iandchasse/silkscreen-light-strip/docs/reports/design_summary.md

# As-built design summary (generated by tools/report_design.py)

Coordinates: main-board KiCad frame (mm, front view, y down). The tail is drawn unrolled in +y past the
fold line y = 142.965 (panel bottom glass edge); x is preserved through the fold.

Board outline bbox: x 42.975..58.025, y 39.075..166.640
Board thickness 0.1040 mm; copper layers 2

## Footprints
| Ref | Value | Footprint | x | y | rot | pads (num: net @ x,y size) |
|---|---|---|---|---|---|---|
| D1 | XL-4008WWC | LED_SideView_XINGLIGHT_XL-4008 | 44.200 | 50.450 | -90 | 1: /W1_2 @ 44.250,52.300 1.60x1.00<br>2: /W_A @ 44.250,48.600 1.60x1.00 |
| D2 | XL-4008WWC | LED_SideView_XINGLIGHT_XL-4008 | 44.200 | 67.450 | -90 | 1: /W2_3 @ 44.250,69.300 1.60x1.00<br>2: /W1_2 @ 44.250,65.600 1.60x1.00 |
| D3 | XL-4008WWC | LED_SideView_XINGLIGHT_XL-4008 | 44.200 | 83.000 | -90 | 1: /W3_4 @ 44.250,84.850 1.60x1.00<br>2: /W2_3 @ 44.250,81.150 1.60x1.00 |
| D4 | XL-4008WWC | LED_SideView_XINGLIGHT_XL-4008 | 44.200 | 98.550 | -90 | 1: /W4_5 @ 44.250,100.400 1.60x1.00<br>2: /W3_4 @ 44.250,96.700 1.60x1.00 |
| D5 | XL-4008WWC | LED_SideView_XINGLIGHT_XL-4008 | 44.200 | 114.100 | -90 | 1: /W5_6 @ 44.250,115.950 1.60x1.00<br>2: /W4_5 @ 44.250,112.250 1.60x1.00 |
| D6 | XL-4008WWC | LED_SideView_XINGLIGHT_XL-4008 | 44.200 | 129.650 | -90 | 1: /W- @ 44.250,131.500 1.60x1.00<br>2: /W5_6 @ 44.250,127.800 1.60x1.00 |
| D7 | XL-4008UWC | LED_SideView_XINGLIGHT_XL-4008 | 44.200 | 43.850 | -90 | 1: /C7_8 @ 44.250,45.700 1.60x1.00<br>2: /C_A @ 44.250,42.000 1.60x1.00 |
| D8 | XL-4008UWC | LED_SideView_XINGLIGHT_XL-4008 | 44.200 | 60.850 | -90 | 1: /C8_9 @ 44.250,62.700 1.60x1.00<br>2: /C7_8 @ 44.250,59.000 1.60x1.00 |
| D9 | XL-4008UWC | LED_SideView_XINGLIGHT_XL-4008 | 44.200 | 76.400 | -90 | 1: /C9_10 @ 44.250,78.250 1.60x1.00<br>2: /C8_9 @ 44.250,74.550 1.60x1.00 |
| D10 | XL-4008UWC | LED_SideView_XINGLIGHT_XL-4008 | 44.200 | 91.950 | -90 | 1: /C10_11 @ 44.250,93.800 1.60x1.00<br>2: /C9_10 @ 44.250,90.100 1.60x1.00 |
| D11 | XL-4008UWC | LED_SideView_XINGLIGHT_XL-4008 | 44.200 | 107.500 | -90 | 1: /C11_12 @ 44.250,109.350 1.60x1.00<br>2: /C10_11 @ 44.250,105.650 1.60x1.00 |
| D12 | XL-4008UWC | LED_SideView_XINGLIGHT_XL-4008 | 44.200 | 123.050 | -90 | 1: /C- @ 44.250,124.900 1.60x1.00<br>2: /C11_12 @ 44.250,121.200 1.60x1.00 |
| D13 | BAV70W | SOT-323_SC-70 | 56.340 | 155.015 | 90 | 1: /LED_SW @ 55.690,156.015 0.45x0.70<br>2: /W- @ 56.990,156.015 0.45x0.70<br>3: /W_A @ 56.340,154.015 0.45x0.70 |
| D14 | BAV70W | SOT-323_SC-70 | 53.840 | 155.015 | 90 | 1: /LED_SW @ 53.190,156.015 0.45x0.70<br>2: /C- @ 54.490,156.015 0.45x0.70<br>3: /C_A @ 53.840,154.015 0.45x0.70 |
| J1 | FPC tail to J3 | FPC_Tail_FH34SRJ_6P_P0.50mm_TopContact | 54.237 | 166.615 | 0 | 1: /LED_SW @ 52.987,165.515 0.30x1.80<br>2: /C- @ 53.487,165.515 0.30x1.80<br>3: unconnected-(J1-NC-Pad3) @ 53.987,165.515 0.30x1.80<br>4: unconnected-(J1-NC-Pad4) @ 54.487,165.515 0.30x1.80<br>5: /LED_SW @ 54.987,165.515 0.30x1.80<br>6: /W- @ 55.487,165.515 0.30x1.80 |
| TP1 | LED_SW | TestPad_0.8mm_Wire | 53.190 | 158.965 | 0 | 1: /LED_SW @ 53.190,158.965 0.80x0.80 |
| TP2 | C- | TestPad_0.8mm_Wire | 54.490 | 157.465 | 0 | 1: /C- @ 54.490,157.465 0.80x0.80 |
| TP3 | W- | TestPad_0.8mm_Wire | 56.990 | 157.465 | 0 | 1: /W- @ 56.990,157.465 0.80x0.80 |

## Copper by net
| Net | F.Cu mm | B.Cu mm | widths | vias |
|---|---|---|---|---|
| /C- | 51.2 | 0.0 | [0.2, 0.3, 0.4] | [] |
| /C10_11 | 13.2 | 0.0 | [0.2] | [] |
| /C11_12 | 13.2 | 0.0 | [0.2] | [] |
| /C7_8 | 14.6 | 0.0 | [0.2] | [] |
| /C8_9 | 13.2 | 0.0 | [0.2] | [] |
| /C9_10 | 13.2 | 0.0 | [0.2] | [] |
| /C_A | 19.6 | 103.6 | [0.2, 0.4] | [(44.2, 40.6), (50.4, 138.4)] |
| /LED_SW | 19.1 | 2.5 | [0.3, 0.4] | [(55.69, 158.965), (53.19, 158.965)] |
| /W- | 46.3 | 0.0 | [0.3, 0.4] | [] |
| /W1_2 | 2.8 | 10.4 | [0.2] | [(44.2, 53.7), (44.2, 64.15)] |
| /W2_3 | 2.8 | 9.0 | [0.2] | [(44.2, 70.7), (44.2, 79.7)] |
| /W3_4 | 2.8 | 9.0 | [0.2] | [(44.2, 86.25), (44.2, 95.25)] |
| /W4_5 | 2.9 | 9.0 | [0.2] | [(44.2, 110.8), (44.2, 101.8)] |
| /W5_6 | 2.9 | 9.0 | [0.2] | [(44.2, 117.35), (44.2, 126.35)] |
| /W_A | 22.7 | 95.2 | [0.2, 0.4] | [(50.2, 136.8), (44.2, 47.15)] |

## Graphic layers
- Adhesive.3M9077: 3 items
- B.Cu: 16 items
- Bend.Zones: 10 items
- Edge.Cuts: 19 items
- F.Cu: 29 items
- F.Silkscreen: 13 items
- Panel.Reference: 33 items
- Stiffener.PI0.225: 5 items
- User.Comments: 7 items
  - Stiffener.PI0.225 Polygon bbox x 43.000..45.300 y 39.100..54.275
  - Stiffener.PI0.225 Polygon bbox x 43.000..57.968 y 57.900..139.000
  - Stiffener.PI0.225 Polygon bbox x 52.487..58.000 y 152.615..166.615
  - Adhesive.3M9077 Polygon bbox x 43.000..45.300 y 39.100..54.275
  - Adhesive.3M9077 Polygon bbox x 43.000..57.968 y 57.900..139.000
  - Stiffener.PI0.225 text bbox x 60.769..62.231 y 151.641..167.589
  - Stiffener.PI0.225 text bbox x 40.269..41.731 y 76.655..103.345
  - Adhesive.3M9077 text bbox x 40.269..41.731 y 73.474..106.526

## Rule areas
- 'hinge: no vias or pads' on F.Cu,B.Cu: x 42.50..45.80 y 54.27..57.90; no vias=True no pads=True no tracks=False
- 'bend: no vias or pads' on F.Cu,B.Cu: x 51.99..58.50 y 140.70..152.30; no vias=True no pads=True no tracks=False
- 'bend: single-layer copper' on B.Cu: x 51.99..58.50 y 140.70..152.30; no vias=True no pads=True no tracks=True
