iandchasse/silkscreen-light-strip/docs/images/fold368_corner.png

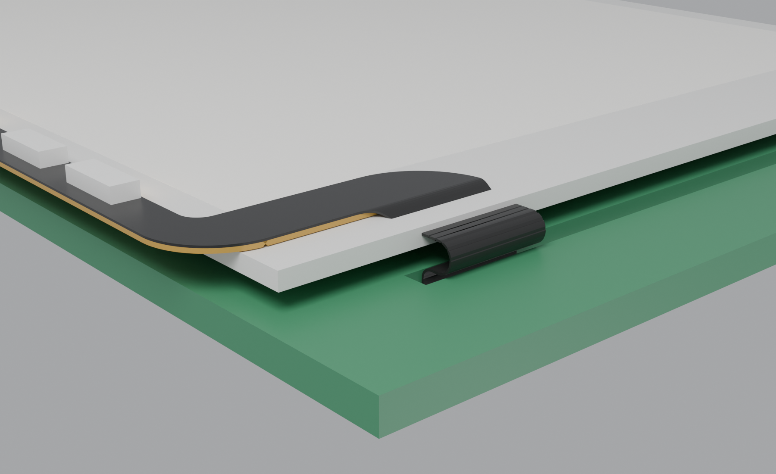
docs/images/fold368_corner.png
