iandchasse/silkscreen-light-strip/docs/images/fold368_night_warm.png

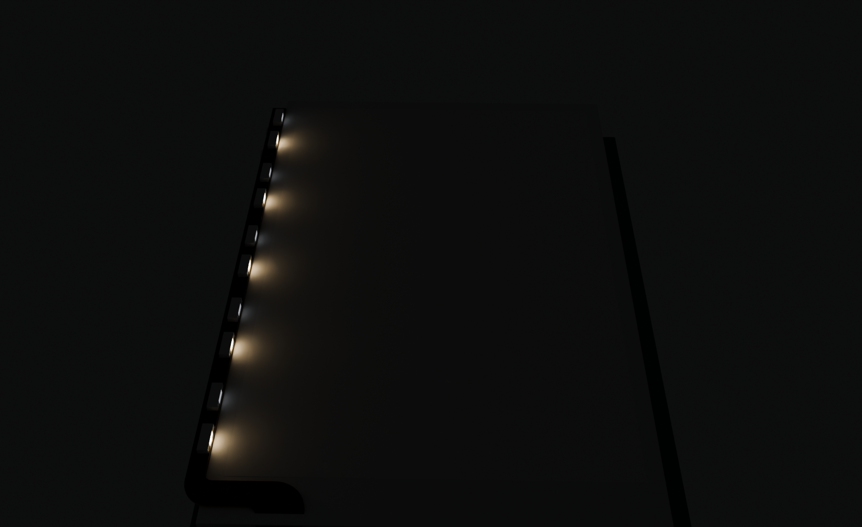
docs/images/fold368_night_warm.png
