iandchasse/silkscreen-light-strip/docs/images/fold_overview.png

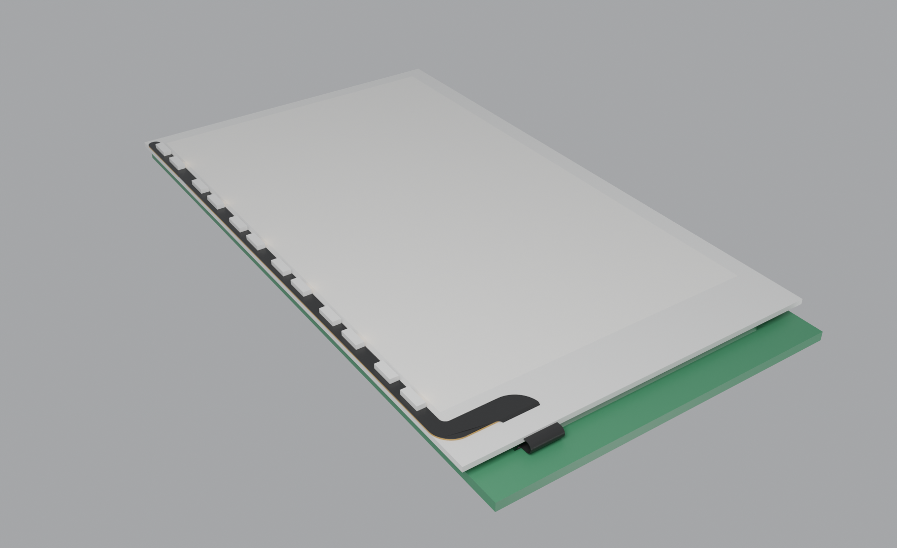
docs/images/fold_overview.png
