iandchasse/silkscreen-light-strip/docs/images/render_back.png

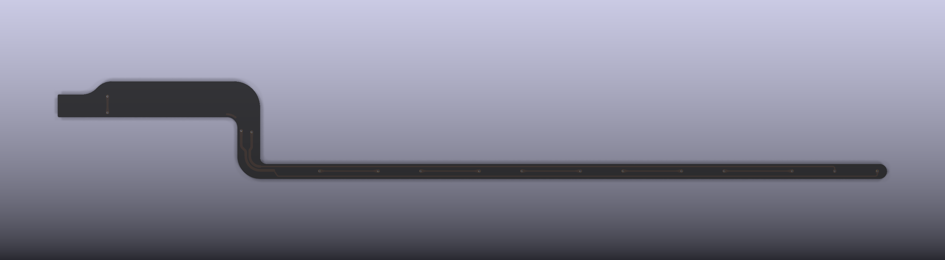
docs/images/render_back.png
