iandchasse/silkscreen-light-strip/docs/images/render_foot_iso.png

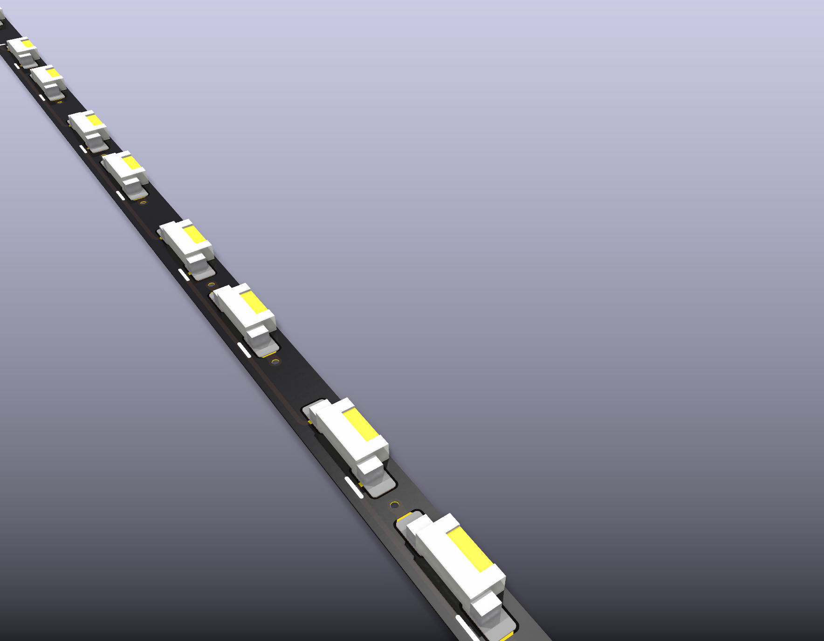
docs/images/render_foot_iso.png
