iandchasse/silkscreen-light-strip/docs/ORDERING.md

# Ordering from JLCPCB

**Rev A is untested.** Before you order, get one LED and diode-test it ([ASSEMBLY.md step 1](ASSEMBLY.md#1-check-led-polarity-before-anything-else)). LCSC sells them for a few cents, and the test settles the one assumption a reversed strip can't recover from.

One strip design fits both readers: the 4.26in panel in `enclosures/case-426`, and the 3.68in panel in `enclosures/case-368`, both in the [silkscreen-enclosures](https://github.com/iandchasse/silkscreen-enclosures) repo. Each reader needs a light-strip case, which is **in development and not released**: the website does not offer them. The light-strip builds are in the silkscreen-enclosures source (its plate files' plate 2 holds the tub); on the 4.26 every other part is the same as the standard build's, and the 3.68 also has its own four bottom keys ([ASSEMBLY.md §8](ASSEMBLY.md#8-the-case)). You can order and bench-test the strip before printing either.

## Files

| File | Use |
|---|---|
| `production/silkscreen-light-strip_rev-A_gerbers.zip` | Upload this to the flex order. It holds the copper, coverlay (mask), silk, paste, outline and drill files, plus two extra layers: `…-Stiffener_PI0_225.gbr` and `…-Adhesive_3M9077.gbr`. |
| `production/jlc_bom.csv`, `production/jlc_cpl.csv` | Only for an assembled order |
| `production/bom.csv` | Parts list for hand assembly or an LCSC order |

JLC does not read the stiffener or tape layers automatically. You have to choose them on the form and name the files in the remark, as below.

### With the Fabrication Toolkit plugin

You can also make the order files with the Fabrication Toolkit plugin in KiCad's PCB editor instead of `make_outputs.py`:

- **BOM.** Every placed part has an `LCSC` field, which the toolkit puts in its BOM. J1 (the contact tail) and the test pads TP1–TP3 are left out of the BOM and placement.
- **Placement.** The diodes D13 and D14 carry `FT Rotation Offset` = 180 (the LEDs 0), so the toolkit's placement file matches `jlc_cpl.csv`.
- **Layers.** `fabrication-toolkit-options.json`, next to the board, preselects the extra layers `User.1,User.2` (stiffener and adhesive). The bend-zone layer (User.3) stays out. It also names the outputs `silkscreen-light-strip_rev-A_fab-toolkit…` (the revision comes from the title block), so they don't overwrite `production/bom.csv`.
- **Leave two boxes unticked:** "Set User.1 as V-Cut layer" and "Set User.2 as alternative Edge-Cut layer". On this board those layers are the stiffener and the tape.
- **Coverlay.** Each footprint pins its coverlay opening at 0.1 mm, so no plugin setting can change it.

Checked with toolkit 5.2.0 on KiCad 9.0.6: every layer both tools make, and the drill, are geometrically identical to `make_outputs.py`'s. The toolkit adds an empty B.Paste file and drill maps.

## Order form (Flex PCB)

| Field | Setting |
|---|---|
| Base material | **Flex** |
| Layers | **2** |
| Dimensions | Taken from the outline, about 15.1 × 127.6 mm |
| Quantity | 5, the minimum |
| FPC thickness | **0.11 mm** (25 µm PI core) |
| Copper | 1/3 oz (12 µm), the standard for 2-layer 0.11 mm |
| Coverlay colour | **Black**. It hides under the bezel and doesn't reflect amber. Yellow works if you prefer the cheaper default. |
| Silkscreen | **White** |
| Surface finish | **ENIG**, 1 U″. 2 U″ is worth it if you expect to re-insert the tail often; the main board's frontlight connector (J3) is rated for 20 cycles. |
| Coverlay thickness | PI 12.5 µm / adhesive 15 µm (the only choice at 1/3 oz) |
| EDA software | **Other.** JLC's form warns that stiffeners from other software "require manual review". That is what this board wants anyway; the EasyEDA discount ($7.37) isn't worth porting the design. |
| Stiffener | **Polyimide, 0.225 mm** and **3M Tape, 3M9077**, selected together in one row. The PI goes on the bottom side, in the three areas in `…-Stiffener_PI0_225.gbr`. The tape goes on the bottom side of the two front stiffener pieces, stacked on the PI, in `…-Adhesive_3M9077.gbr`. Take 3M9077 (0.05 mm, heat-resistant) even though JLC recommends tesa8854 (0.1 mm): the LED tops clear the case skin by only 0.215 mm, and the design counts 0.05 of tape. 3M468 (0.13 mm) isn't heat-resistant. |
| Tape pull tab | **Yes.** It is a tab on the release liner, so it doesn't change the fit, and it saves picking a 2.3 mm-wide liner off with a fingernail. Put it at the foot end of the bar, away from the hinge. |
| Gold fingers | **Yes, 0.295 mm** (0.29 if the field takes two decimals). The field is the finished finger-area thickness, and JLC picks the stiffener from it: thickness − 0.0705 (the flex without coverlay and back copper). 0.295 leads to the 0.225 PI selected above, and 0.30 would lead their rule up to 0.25 PI (0.3205 nominal, up to 0.35 with ± 0.03, over Hirose's 0.33). |
| EMI shielding film | Without |
| Cutting method | Laser cutting (the default) |
| Confirm production file | **Yes.** JLC sends its production files for approval before making the board. That is where you check the stiffener and tape placement, the bare hinge and the finger-area thickness, since the remark only has room for the essentials. |

**Remark** (the form allows 200 characters; this is 190, paste as is):

> PI stiffener 0.225mm BOTTOM per Stiffener_PI0_225.gbr. 3M9077 tape BOTTOM, stacked on PI, per Adhesive_3M9077.gbr. Keep 3.6mm hinge bare. Finger area 0.30+/-0.03mm (ZIF), do not use 0.25 PI.

**In the production-file review, check these (the full intent behind the remark):**

- **Stiffener:** PI 0.225 mm on the bottom side, in three filled areas: the short piece under the top LED pair, the LED bar + foot, and the last 14 mm of the tail. The tip stiffener is cut with the board outline (R0.2 tip corners).
- **Hinge:** the 3.6 mm gap between the top piece and the bar is bare, with no stiffener and no tape. It is a fold.
- **Tape:** 3M 9077 on the bottom side of the top piece and of the LED bar + foot only, over the PI.
- **Fingers:** they mate a Hirose FH34SRJ ZIF connector, which needs 0.30 ± 0.03 mm at the fingers. With no copper behind them, JLC's formula gives 0.11 − 0.0275 − 0.012 + 0.225 = 0.2955 mm. The finished finger area should be 0.27–0.33 mm.
- **Tab width:** 3.50 mm, ± 0.05 mm. If JLC's outline tolerance is ± 0.1, ask them to hold ± 0.05 here.

**Why the thickness remark.** No PI option lands exactly on 0.30:

- **0.225** gives 0.2955 nominal. With JLC's ± 0.03 its low end is 0.2655, 4.5 µm under Hirose's 0.27.
- **0.25** gives 0.3205. JLC's own calculator rounds up to this one, but its high end is 0.3505, well over Hirose's 0.33.

So the remark fixes 0.225 and asks JLC to hold the low side. JLC's capability page also recommends 0.225 mm for a 0.3 mm contact on 0.11 mm flex.

After upload, check the online Gerber viewer:

- the outline is one closed shape with rounded corners;
- the six gold fingers are at the narrow tip;
- three stiffener areas: the short top piece, the long bar/foot, and the tail end, with a bare gap between the first two.

## Bare board or assembled?

**Bare, soldered by hand (recommended for rev A).** It is cheap and simple, and it lets you do the polarity test first. Order the parts from LCSC. Buy spares, since each part costs a few cents:

| Part | LCSC | Need | Suggested |
|---|---|---|---|
| XINGLIGHT XL-4008WWC (warm) | C5440667 | 6 per strip | 10–20 |
| XINGLIGHT XL-4008UWC (cool) | C2843774 | 6 per strip | 10–20 |
| Nexperia BAV70W,115 | C28064 | 2 per strip | 20 (LCSC sells it in multiples of 20; also stocked at DigiKey) |

**Assembled by JLC.** This is possible, but costs more and has more to check:

- **Assembly service.** Flex assembly needs a fixture ($23.57) and a panel with rails and fiducials. The files don't include one, so choose **"Panel by JLCPCB"**. Use Standard PCBA.
- **Parts.** All three parts are JLC **Extended** parts, so expect a feeder fee of about $3 each.
- **Files.** Upload `jlc_bom.csv` and `jlc_cpl.csv` (or the Fabrication Toolkit's BOM and positions files). The CPL already carries the rotation corrections for JLC's library footprints (SOT-323 +180°, LED 0°).
- **Check every part in the placement preview:**
  - **LEDs:** the window faces the bar's **inner** edge, toward the screen side. The anode goes on the upper pad, toward the rounded top end. The cathode goes on the pad with the short white silk bar.
    - JLC's polarity dot sits at opposite ends for the two parts: on the anode (upper) pad for the warm C5440667, and on the cathode (lower) pad for the cool C2843774.
    - Judge by the window direction and the anode position, not the dot.
    - Tell JLC not to rotate the warm LEDs to line up the dots. Rotating a side-view LED turns its light away from the screen.
  - **Warm/cool:** warm (C5440667) in the lower position of each pair, D1–D6; cool (C2843774) in the upper, D7–D12.
  - **BAV70W (D13, D14):** the single pin (pin 3) points toward the LED end.

  If any of these looks wrong, fix it in the preview or ask JLC before paying. A reversed side-view LED can't be corrected afterwards.

## Cost ballpark

This is unverified: no instant quote has been run with these files. Upload the zip to get the real figure.

| | Estimate |
|---|---|
| 5 bare flex (2L 0.11 mm, ENIG, PI stiffener in three areas, 3M 9077 stacked) | about $45–75, plus $15–25 shipping. Black coverlay may add a little. |
| LEDs and diodes for hand assembly (with spares) | a few dollars, plus LCSC shipping |
| Assembly of 2 of the 5 by JLC | add about $65–95: setup, stencil, FPC fixture, 3 Extended-part fees, parts and the panel |

## Before you pay

- [ ] One LED diode-tested ([ASSEMBLY.md step 1](ASSEMBLY.md#1-check-led-polarity-before-anything-else))
- [ ] Your panel is a plain **GDEY0426T82** (no bonded frontlight) or the **3.68in 528 × 792** panel of the x3 build
- [ ] The main board has the frontlight driver and the frontlight connector populated (U10, Q5, Q6, R37 and J3 on the board). The trimmed x3 board keeps all of it.
- [ ] You know the light-strip case for your reader is still in development, and what it needs ([ASSEMBLY.md §8](ASSEMBLY.md#8-the-case))
- [ ] FPC thickness 0.11, black coverlay, ENIG, PI 0.225 stiffener (not 0.25) in three areas, 3M 9077 stacked, and the remark pasted
