iandchasse/silkscreen-light-strip/production/jlc_bom.csv

Comment | Designator | Footprint | JLCPCB Part #
XL-4008WWC | D1,D2,D3,D4,D5,D6 | LED_SideView_XINGLIGHT_XL-4008 | C5440667
XL-4008UWC | D7,D8,D9,D10,D11,D12 | LED_SideView_XINGLIGHT_XL-4008 | C2843774
BAV70W | D13,D14 | SOT-323_SC-70 | C28064
