iandchasse/silkscreen-light-strip/docs/mechanical/silkscreen-light-strip_flat.step

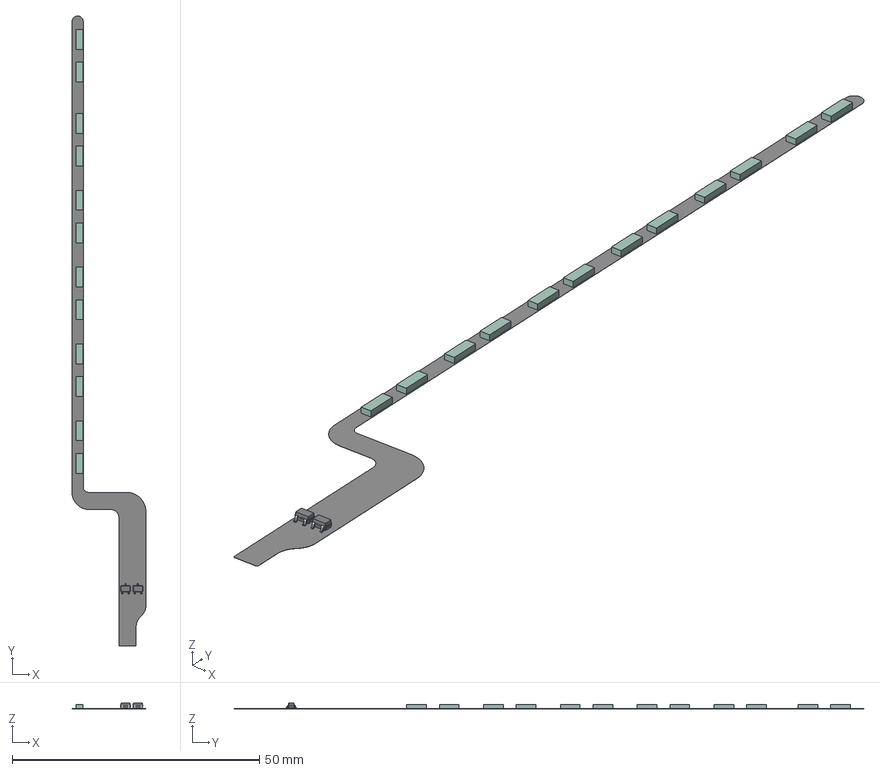
[picture p15: CAD file, 2026-09-25]
docs/mechanical/silkscreen-light-strip_flat.step
15.0 x 127.5 x 1.14 mm
led_body_PCB x 12
SOT-323_SC-70 x 2
silkscreen-light-strip_PCB
