iandchasse/silkscreen-light-strip/docs/silkscreen-light-strip_schematic.pdf

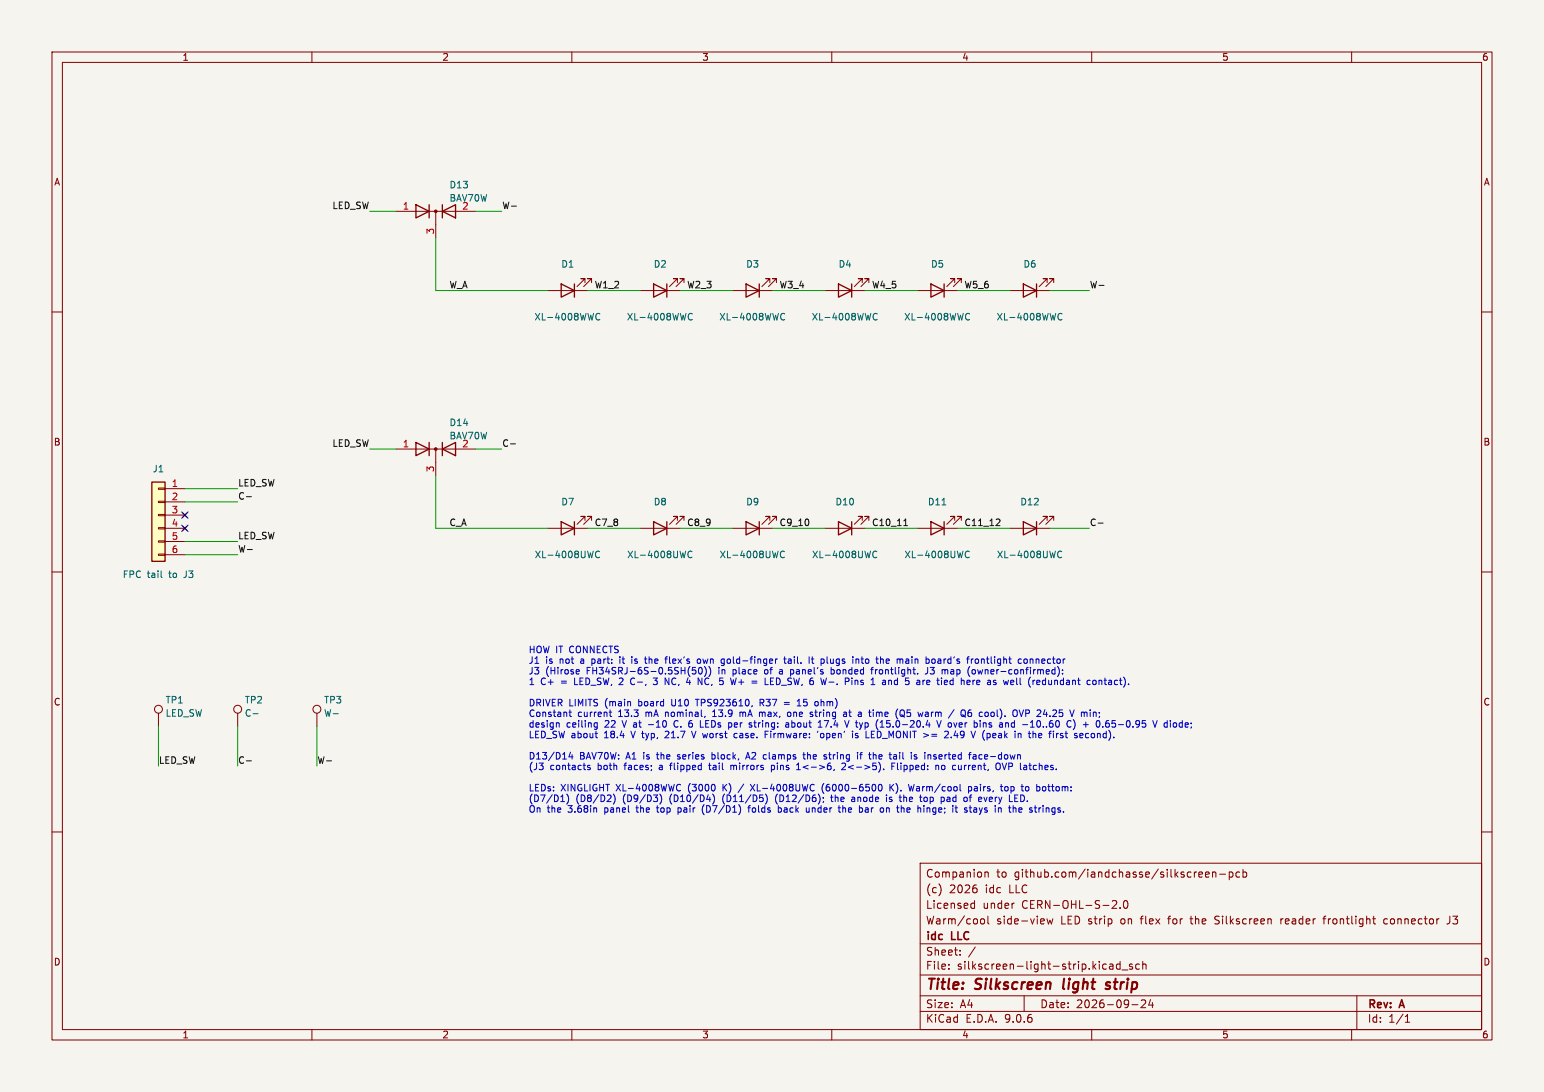
[picture p16: page 1]

File: silkscreen-light-strip.kicad_sch Sheet: /
Id: 1/1 Title: Silkscreen light strip
