iandchasse/silkscreen-light-strip/docs/silkscreen-light-strip_layout.pdf

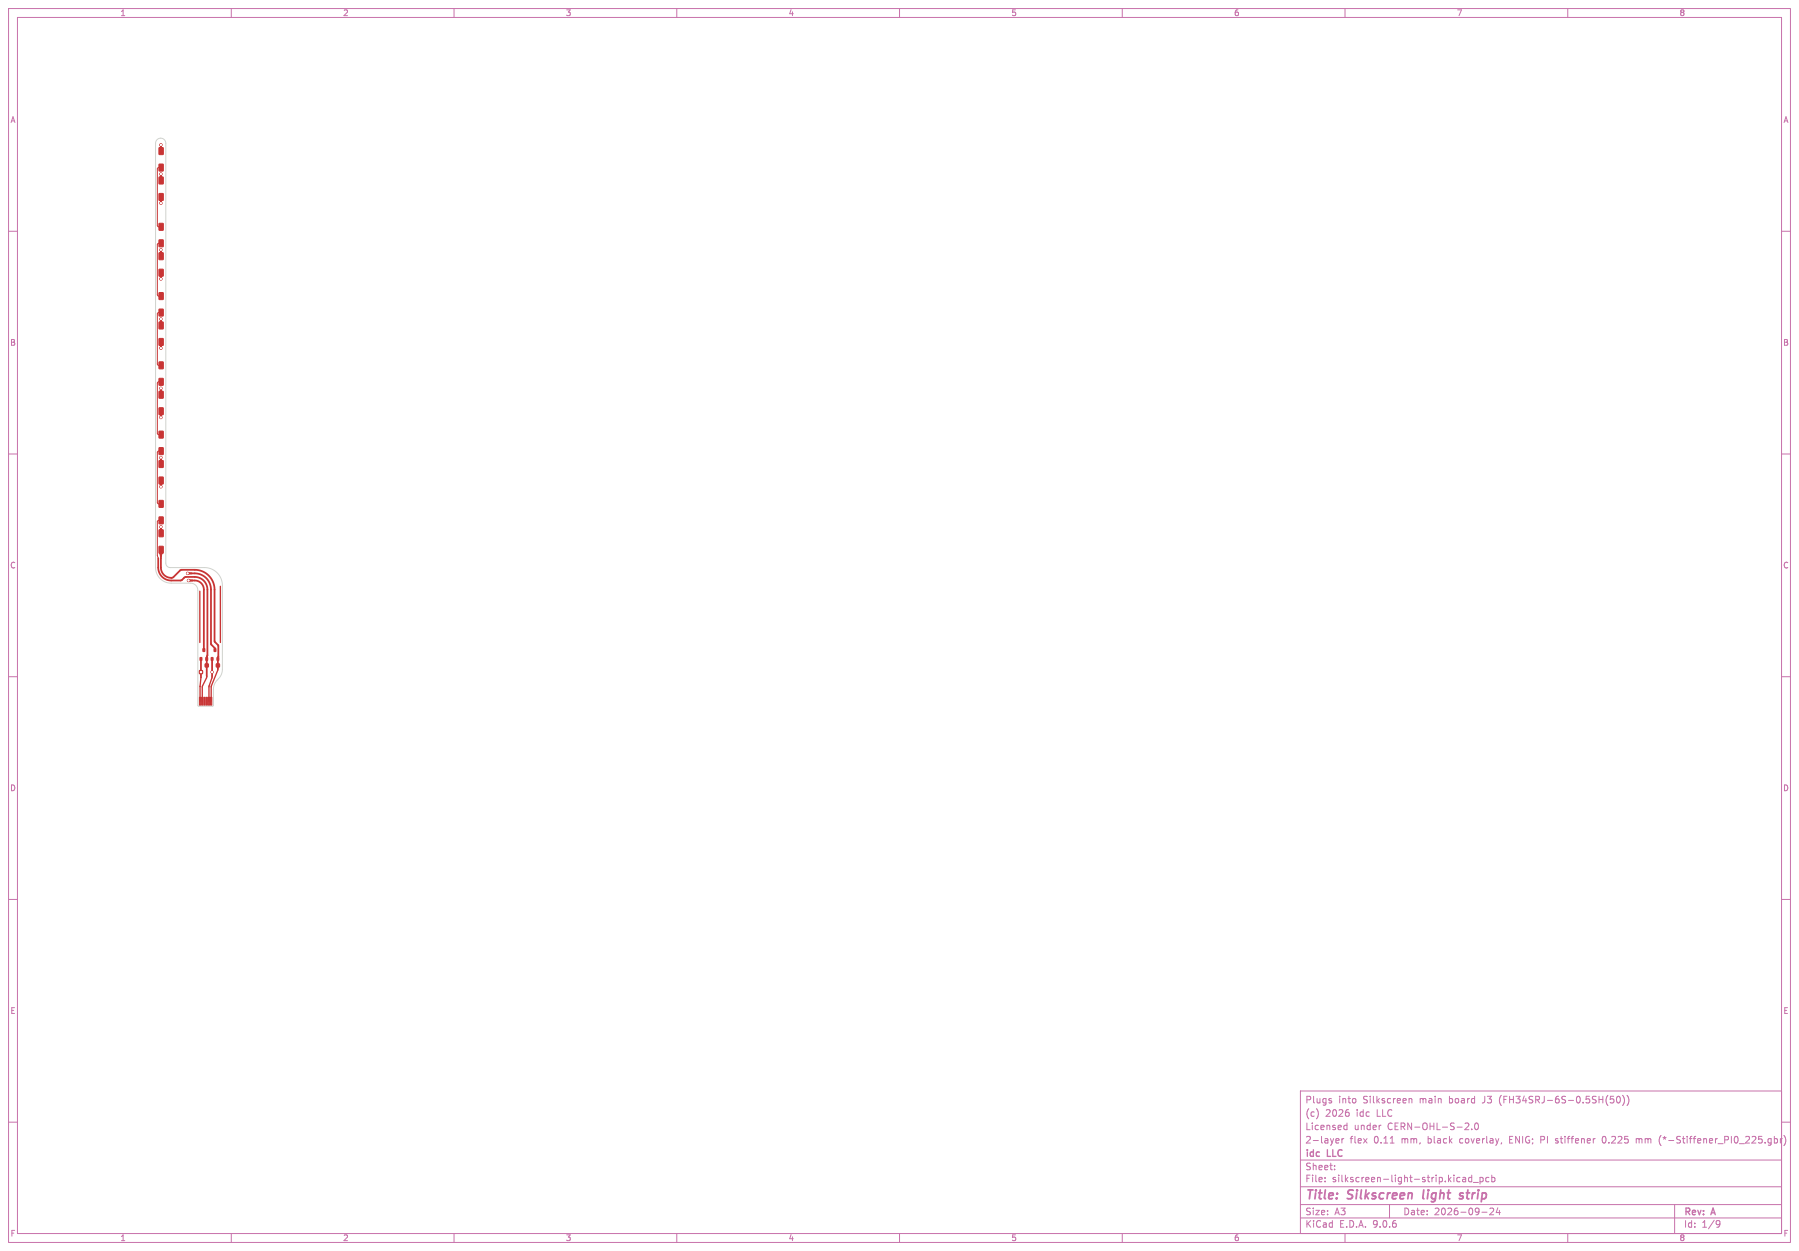
[picture p17: page 1]

File: silkscreen-light-strip.kicad_pcb Sheet:
Id: 1/9 Title: Silkscreen light strip

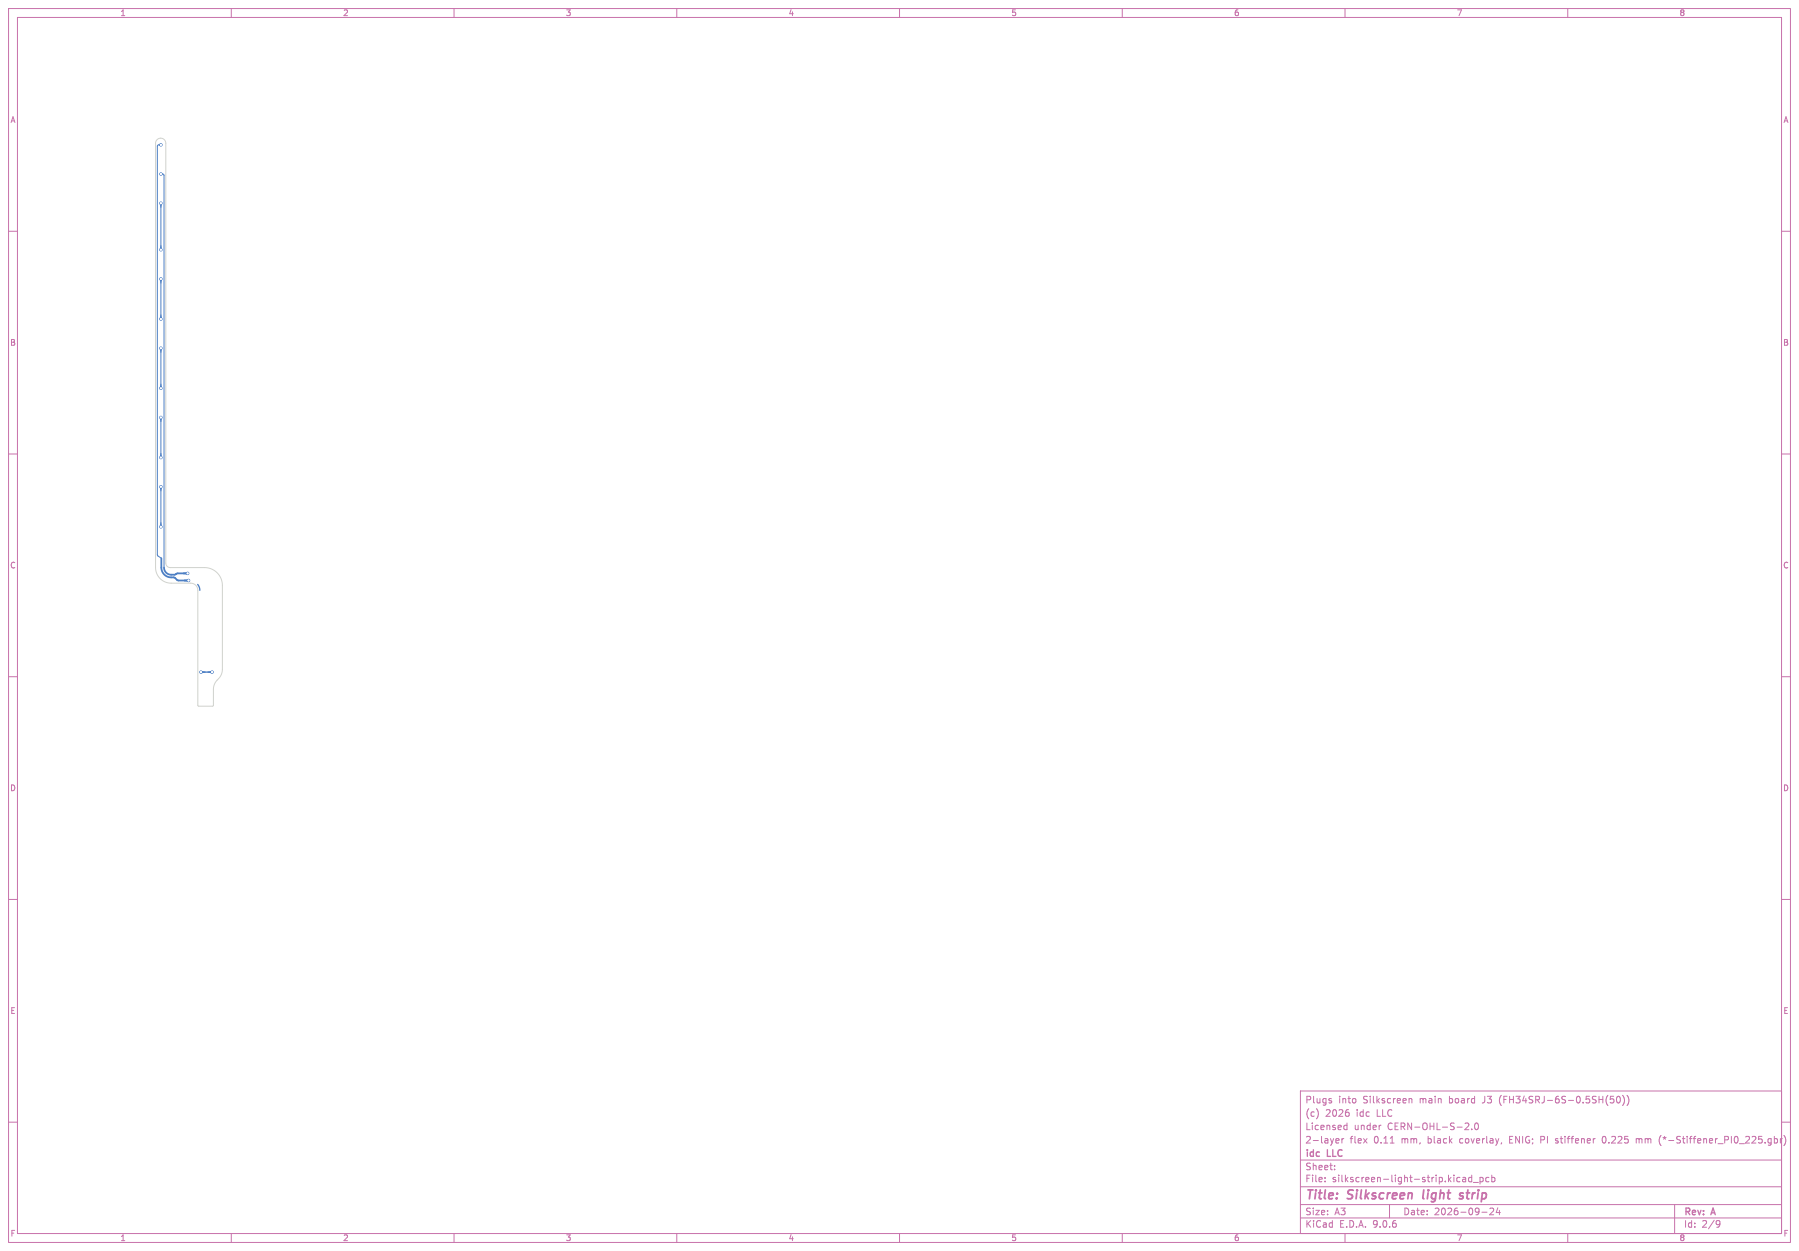
[picture p18: page 2]

File: silkscreen-light-strip.kicad_pcb Sheet:
Id: 2/9 Title: Silkscreen light strip

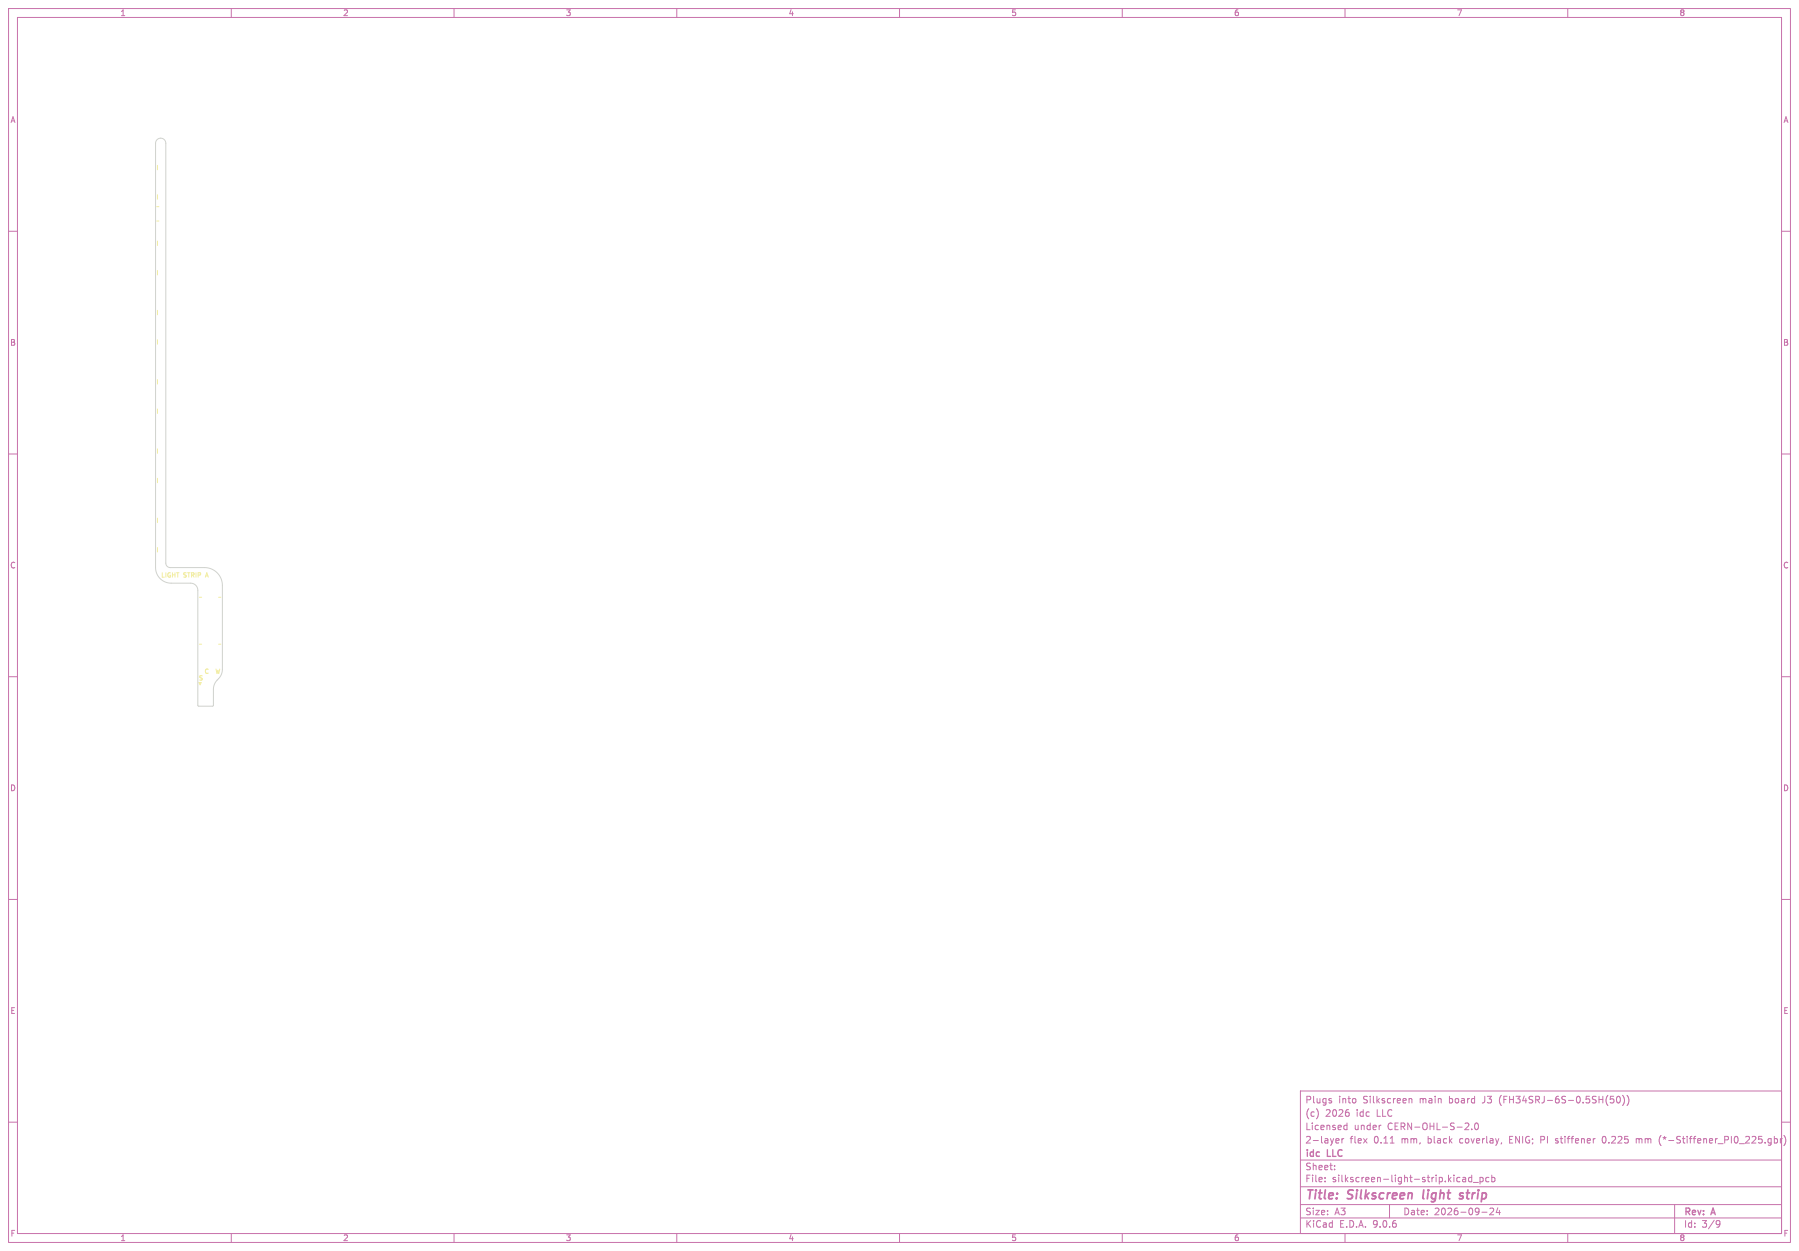
[picture p19: page 3]

File: silkscreen-light-strip.kicad_pcb Sheet:
Id: 3/9 Title: Silkscreen light strip

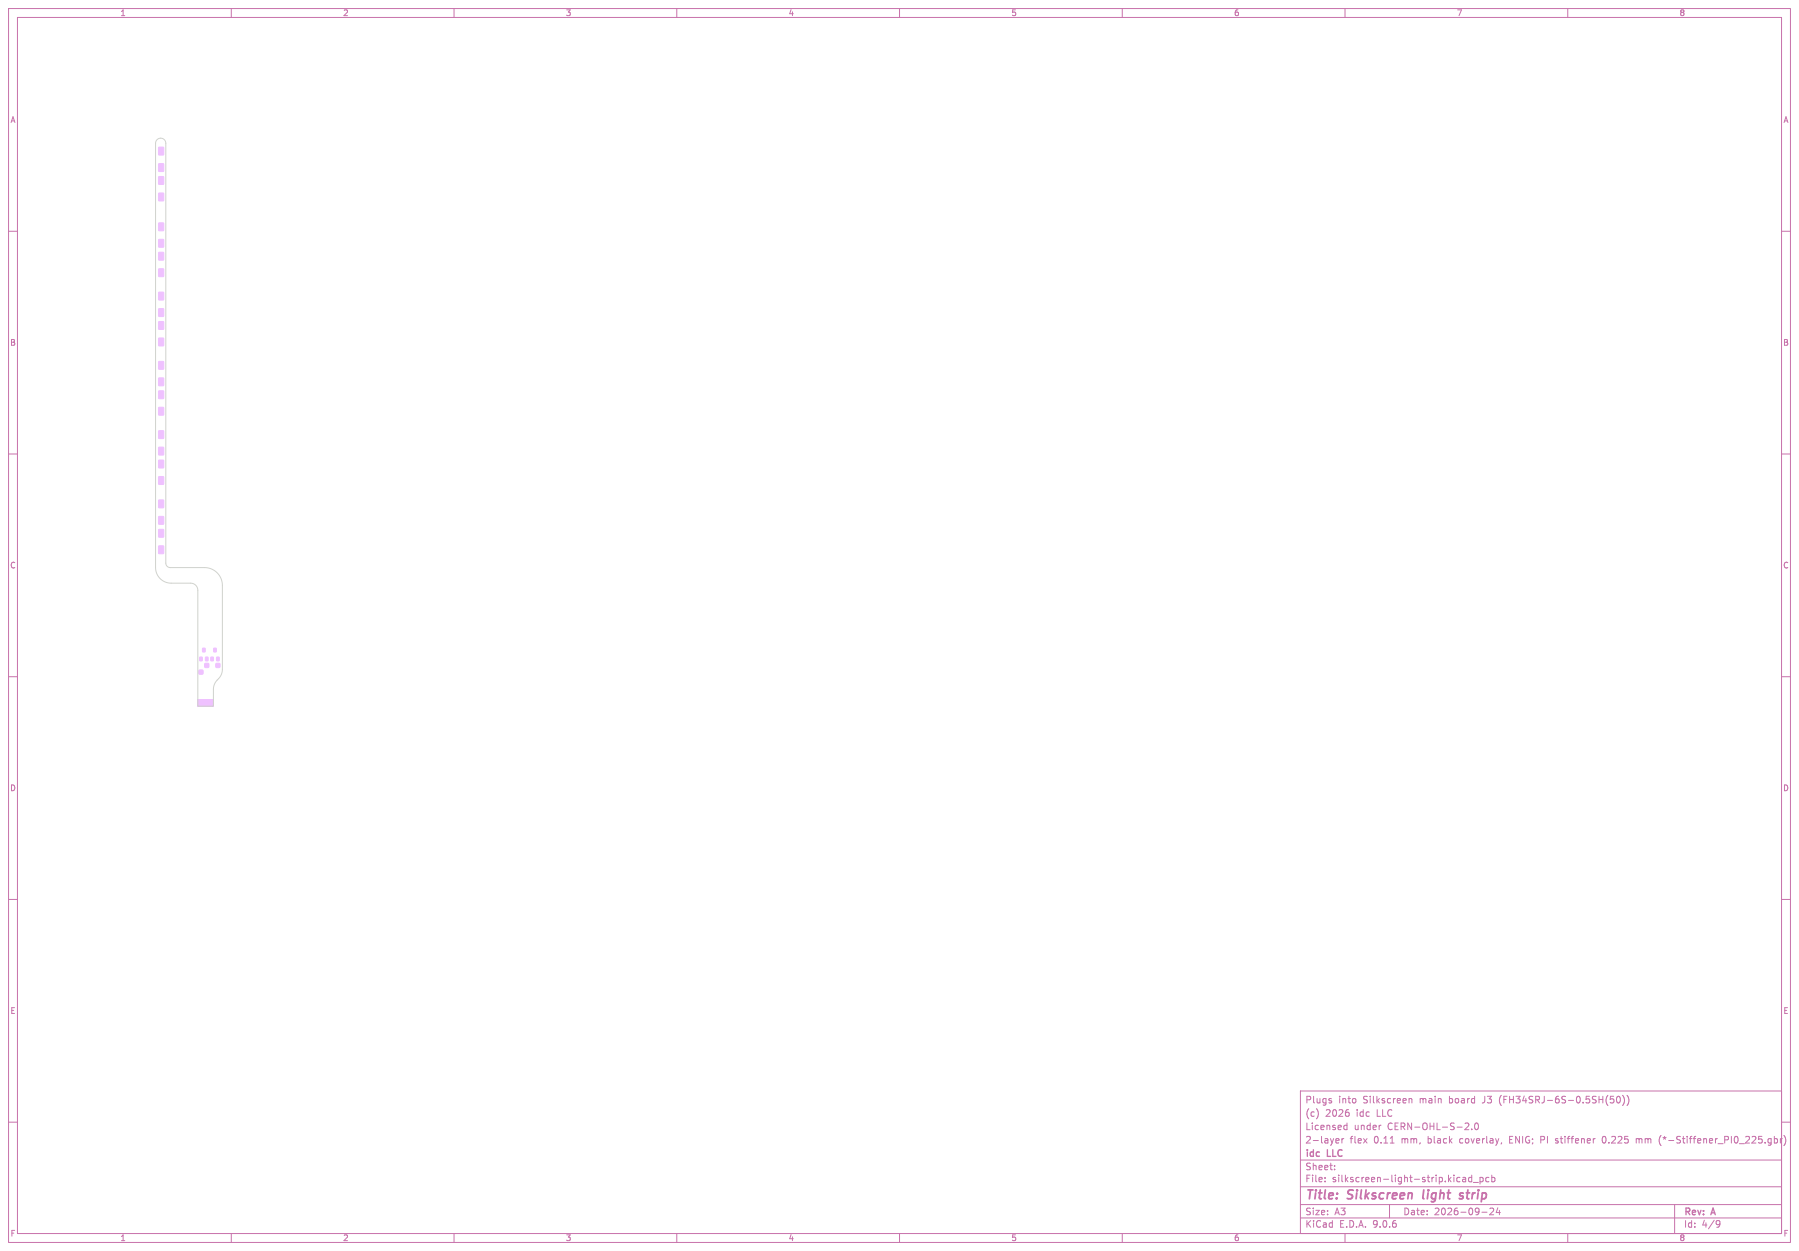
[picture p20: page 4]

File: silkscreen-light-strip.kicad_pcb Sheet:
Id: 4/9 Title: Silkscreen light strip

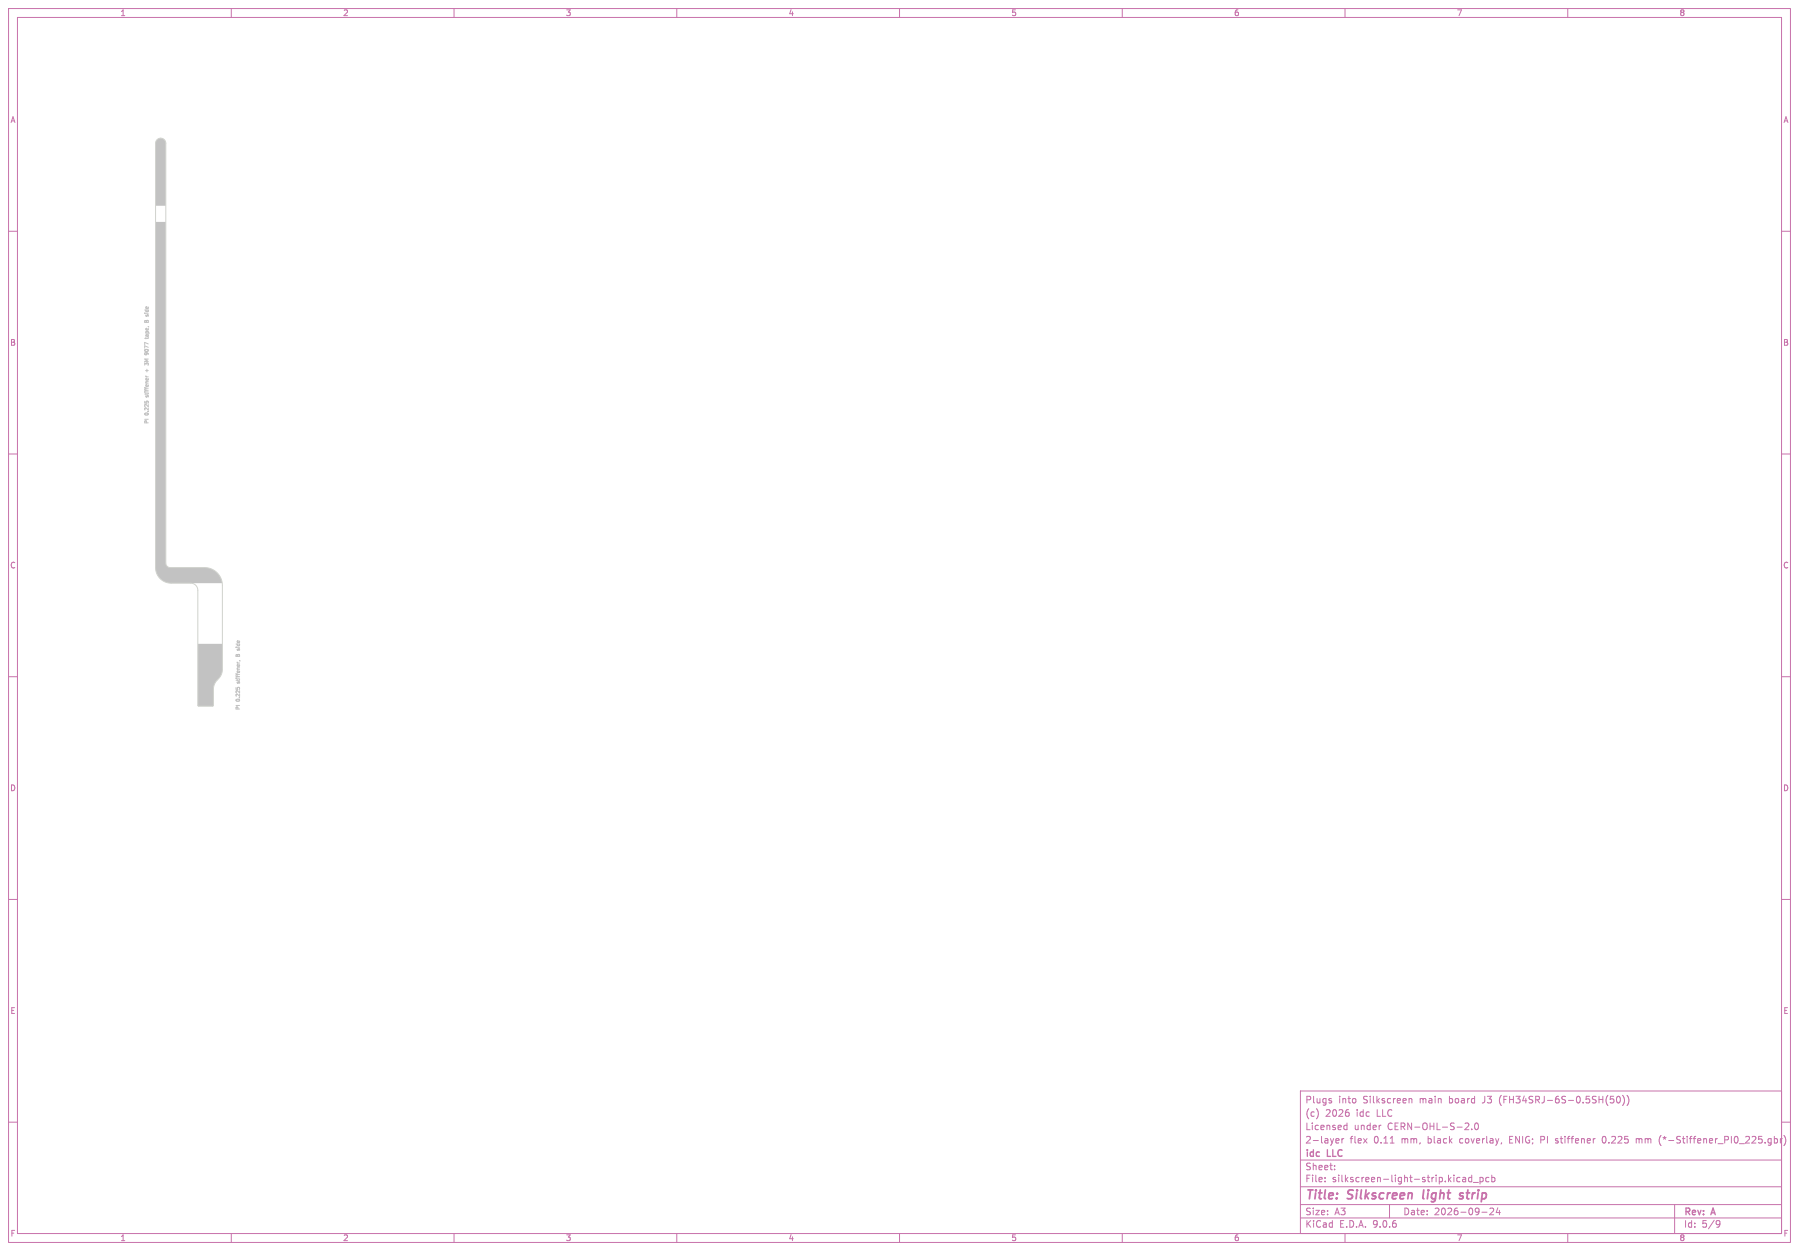
[picture p21: page 5]

File: silkscreen-light-strip.kicad_pcb Sheet:
Id: 5/9 Title: Silkscreen light strip

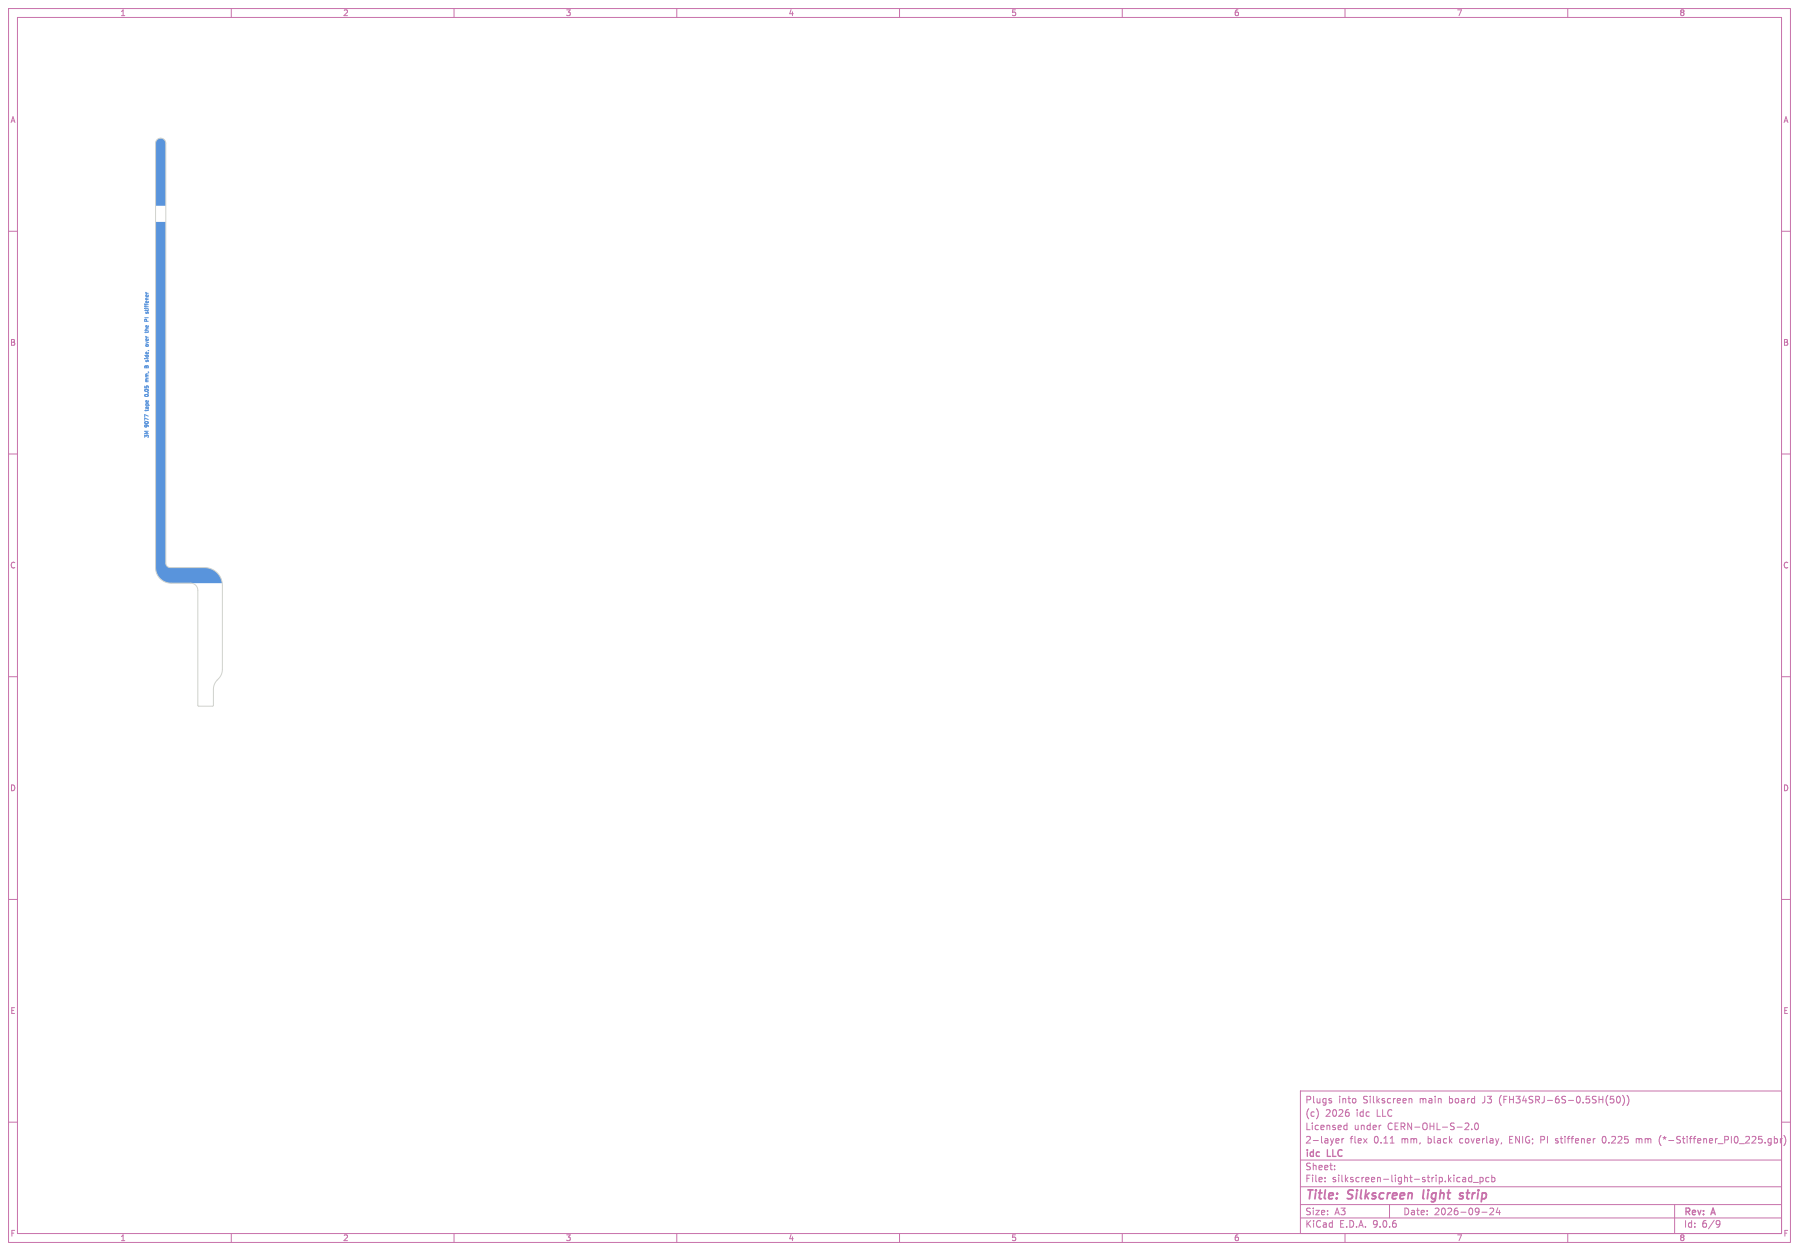
[picture p22: page 6]

File: silkscreen-light-strip.kicad_pcb Sheet:
Id: 6/9 Title: Silkscreen light strip

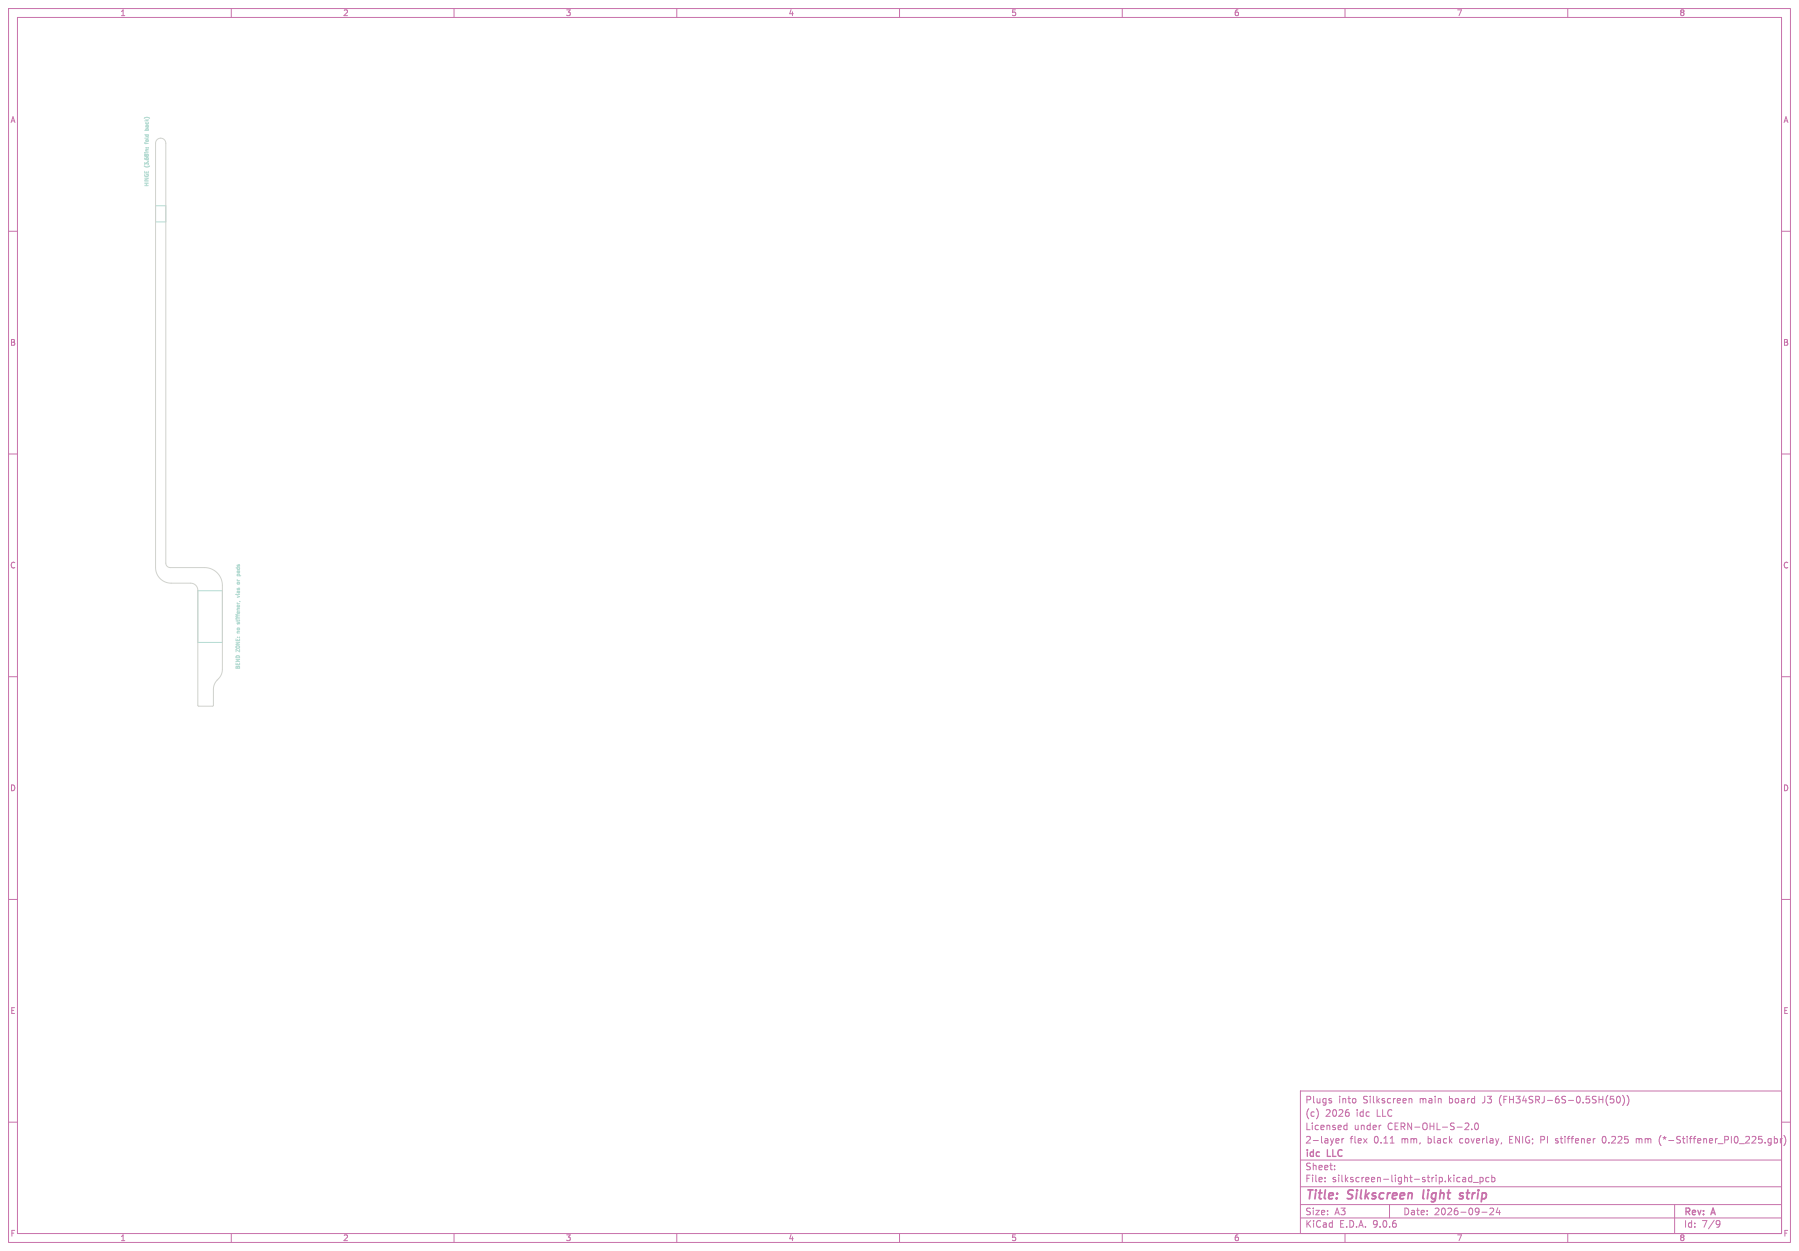
[picture p23: page 7]

File: silkscreen-light-strip.kicad_pcb Sheet:
Id: 7/9 Title: Silkscreen light strip

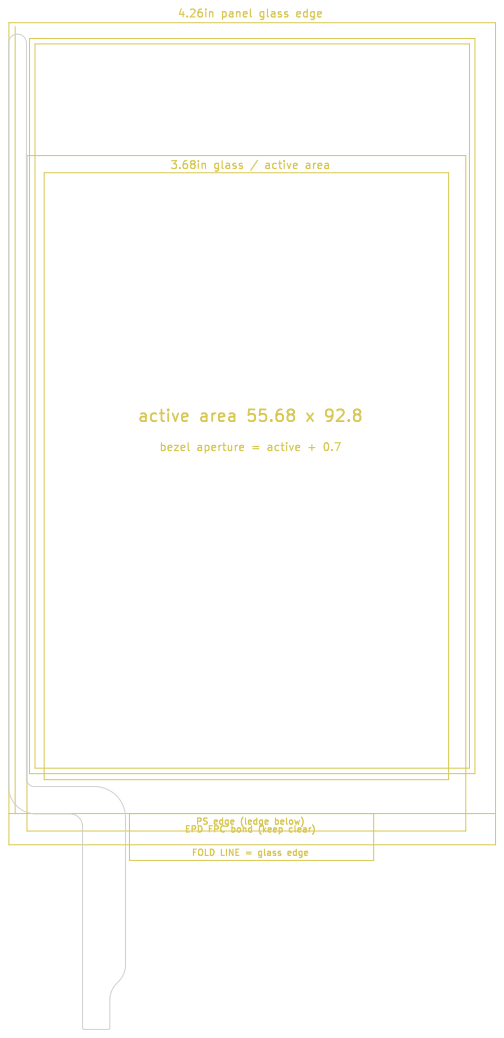
[picture p24: page 8]

File: silkscreen-light-strip.kicad_pcb Sheet:
Id: 8/9 Title: Silkscreen light strip

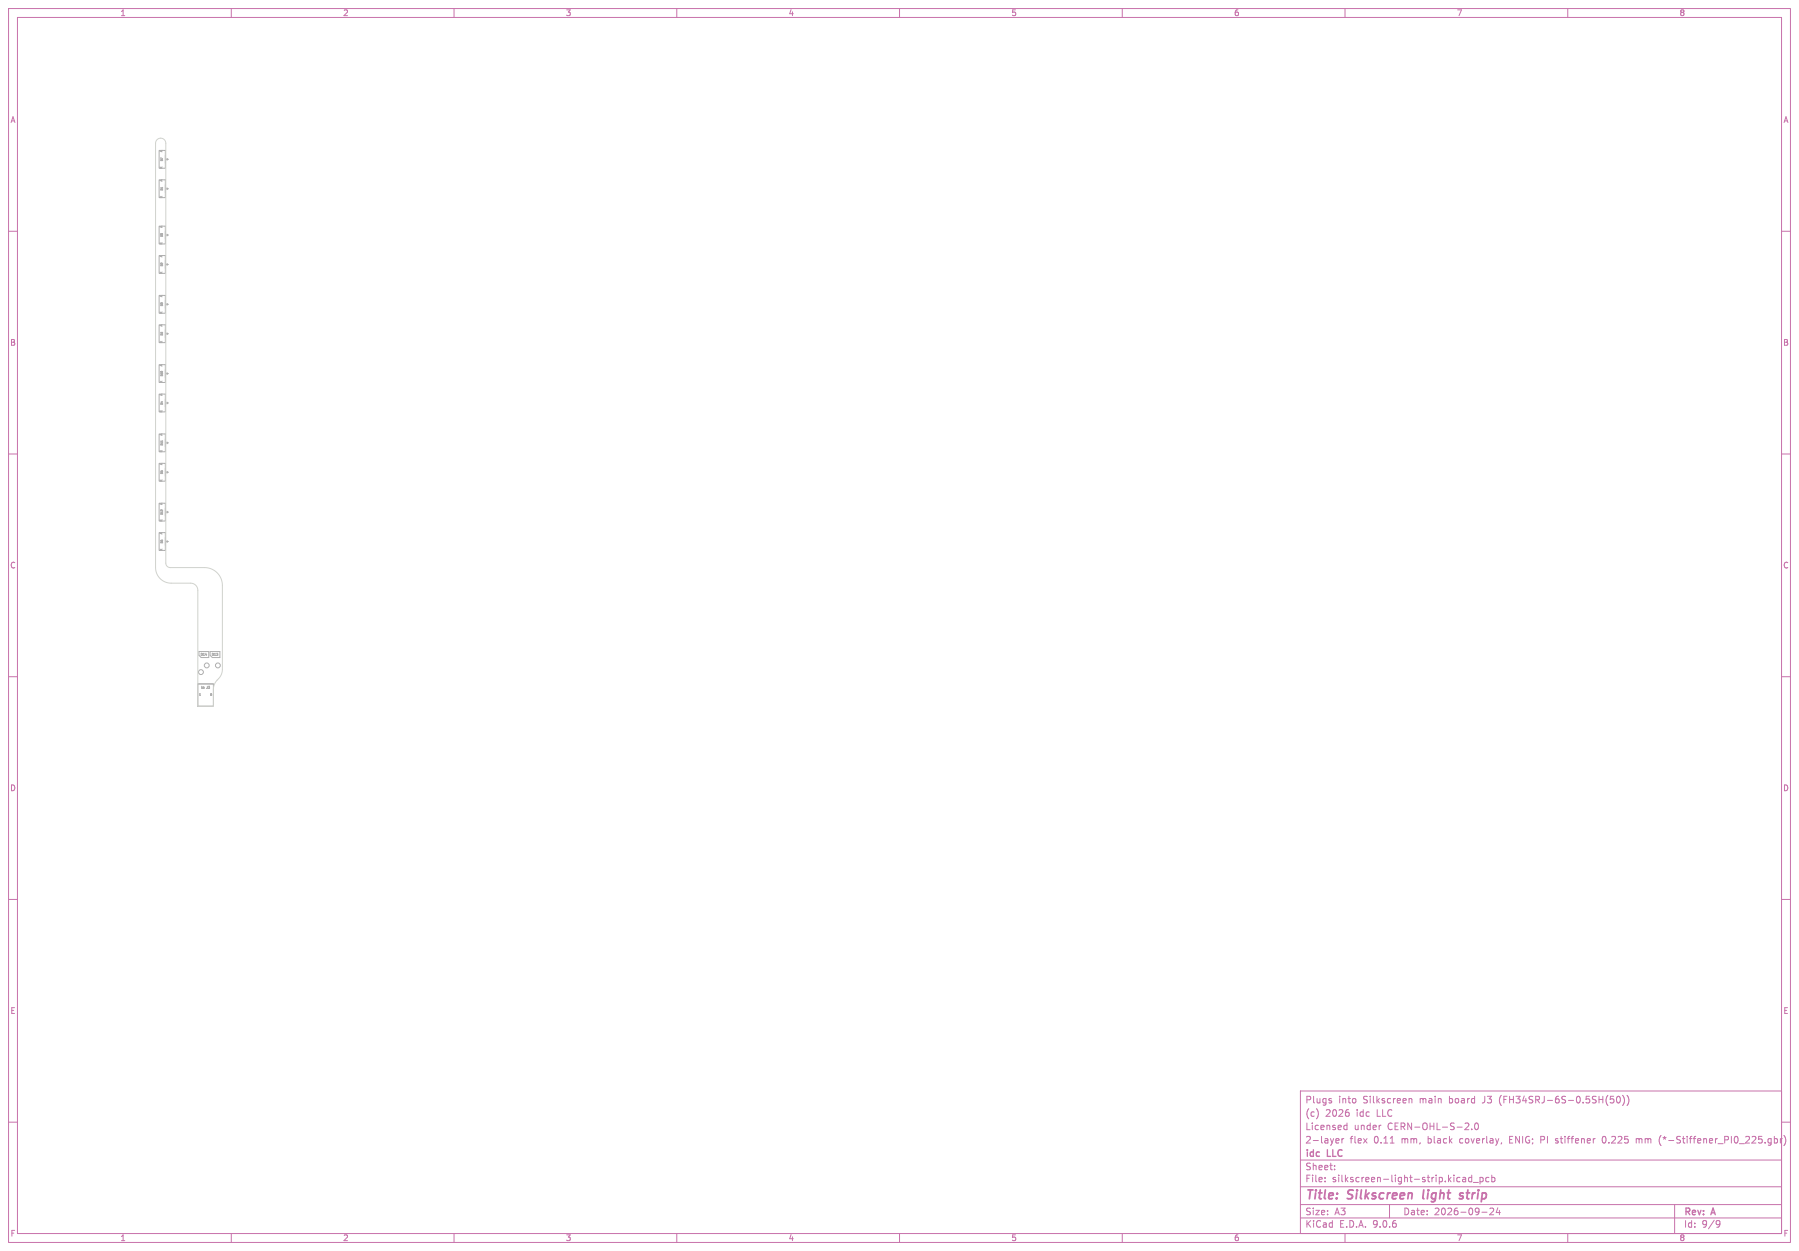
[picture p25: page 9]

File: silkscreen-light-strip.kicad_pcb Sheet:
Id: 9/9 Title: Silkscreen light strip
