iandchasse/silkscreen-light-strip/silkscreen-light-strip.kicad_pcb

## KiCad design silkscreen-light-strip.kicad_pcb (2026-09-26)

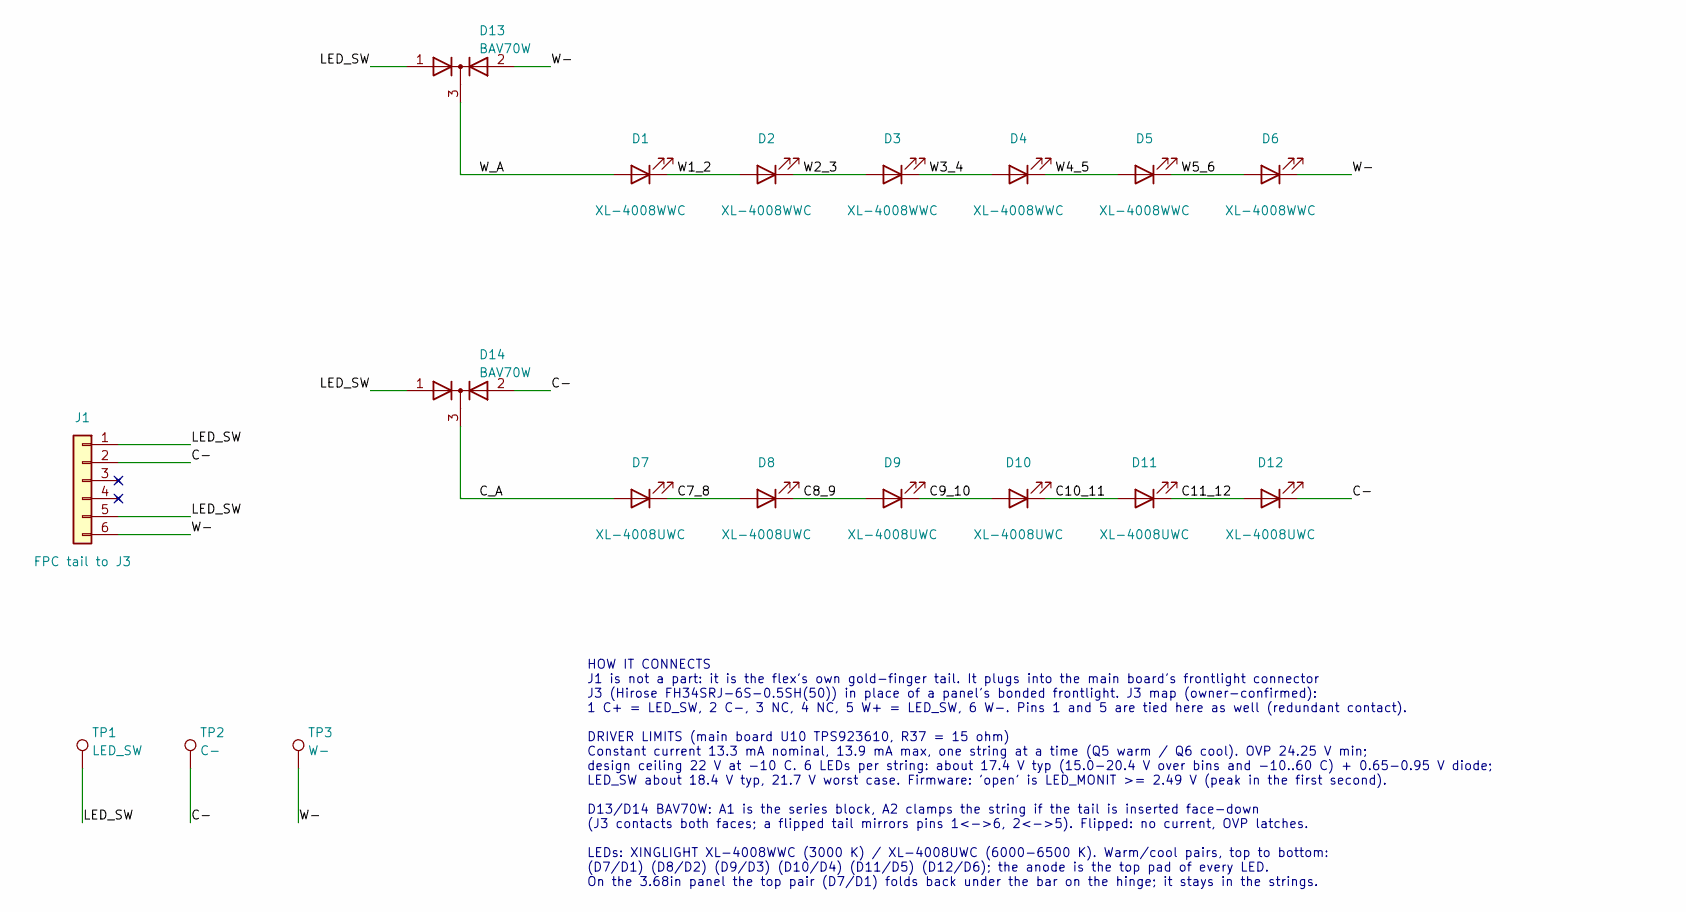
[picture p26: schematic silkscreen-light-strip.kicad_sch, Silkscreen light strip]

Parts:
D1, D2, D3, D4, D5, D6: XL-4008WWC; LED_SideView_XINGLIGHT_XL-4008; MPN XL-4008WWC; LCSC C5440667
D7, D8, D9, D10, D11, D12: XL-4008UWC; LED_SideView_XINGLIGHT_XL-4008; MPN XL-4008UWC; LCSC C2843774
D13, D14: BAV70W; SOT-323_SC-70; MPN BAV70W,115; LCSC C28064
J1: FPC tail to J3; FPC_Tail_FH34SRJ_6P_P0.50mm_TopContact
TP1: LED_SW; TestPad_0.8mm_Wire
TP2: C-; TestPad_0.8mm_Wire
TP3: W-; TestPad_0.8mm_Wire

Connections:
/C7_8: D7.1 (K), D8.2 (A)
/C8_9: D8.1 (K), D9.2 (A)
/C9_10: D9.1 (K), D10.2 (A)
/C10_11: D10.1 (K), D11.2 (A)
/C11_12: D11.1 (K), D12.2 (A)
/C-: D12.1 (K), D14.2 (A), J1.2 (C-), TP2.1
/C_A: D7.2 (A), D14.3 (K)
/LED_SW: D13.1 (A), D14.1 (A), J1.1 (LED_SW(C+)), J1.5 (LED_SW(W+)), TP1.1
/W1_2: D1.1 (K), D2.2 (A)
/W2_3: D2.1 (K), D3.2 (A)
/W3_4: D3.1 (K), D4.2 (A)
/W4_5: D4.1 (K), D5.2 (A)
/W5_6: D5.1 (K), D6.2 (A)
/W-: D6.1 (K), D13.2 (A), J1.6 (W-), TP3.1
/W_A: D1.2 (A), D13.3 (K)

Notes on the sheet:
HOW IT CONNECTS J1 is not a part: it is the flex's own gold-finger tail. It plugs into the main board's frontlight connector J3 (Hirose FH34SRJ-6S-0.5SH(50)) in place of a panel's bonded frontlight. J3 map (owner-confirmed): 1 C+ = LED_SW, 2 C-, 3 NC, 4 NC, 5 W+ = LED_SW, 6 W-. Pins 1 and 5 are tie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

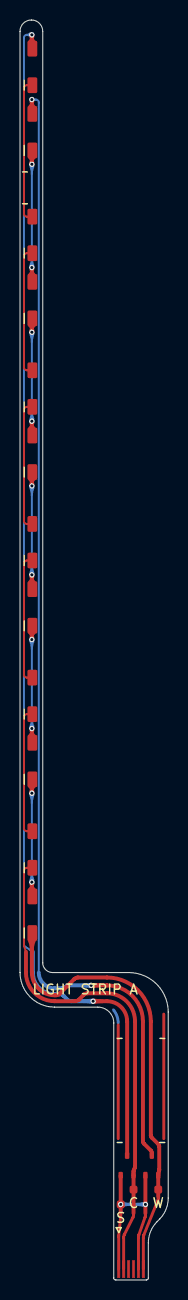
[picture p27: board silkscreen-light-strip.kicad_pcb from above]

Board: 2 copper layers, 15.0 x 127.5 mm, 18 parts (0 on the bottom side), 15 nets.
