iandchasse/silkscreen-light-strip/(commit log)

2026-09-25 Light strip rev A: warm/cool flex frontlight for J3, 4.26in and 3.68in panels
    A generated KiCad 9 project for a 2-layer 0.11 mm flex that plugs into the main
    board's frontlight connector J3 and puts six warm/cool pairs of XINGLIGHT XL-4008
    side-view LEDs along the left edge of the e-paper panel.
    - 6 LEDs per string + BAV70W flip protection; 21.7 V worst case at the driver
    - one layout for both panels: bottom five pairs at 15.55 mm, top pair on its own
    stiffener behind a bare 3.6 mm hinge so it folds back on the 3.68in build
    - large-radius outline, 5.5 mm single-layer neck with tear-stop rails
    - ERC/DRC/parity clean; coverlay clearances and webs measured separately
    - Gerbers, BOM/CPL and J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
    [bom.csv, jlc_bom.csv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]
2026-09-25 Docs and showcase for the final case variants
    DESIGN 4.2/4.3 carry each case's final numbers, the 3.68in rocker-cap
    and latch-arm decisions and the board NOTICE; README, ASSEMBLY and
    ORDERING list the parts each case prints. The showcase loads the final
    case models and drops its interim note.
2026-09-26 Fabrication Toolkit support: rotation-offset fields, pinned coverlay margin, preset layers
    Every placed part already had an LCSC field. D13/D14 now also carry
    FT Rotation Offset = 180 (LEDs 0), from params, so the toolkit's
    placement file matches jlc_cpl.csv. Each footprint pins its coverlay
    opening at the 0.1 mm mask expansion, so a plotter that changes the
    board-wide margin can't shrink it. fabrication-toolkit-options.json
    adds the stiffener and adhesive layers (User.1, User.2), keeps the
    bend zones out and names the outputs apart from production/bom.csv.
    Gerbers and drill are geometrically unchanged.
    [silkscreen-light-strip.kicad_pcb, silkscreen-light-strip.kicad_sch]
2026-09-26 Docs and showcase for the panel-retention fixes
    DESIGN 4.5 summarises how each case holds the panel (checked review
    numbers); 4.2/4.3 describe the longer 4.26in pads and the 3.68in ribbed
    pads and full-depth corner stops. ASSEMBLY 5 starts the 4.26in strip
    fitting with the strip-thickness check. Showcase case models re-exported.
2026-09-26 Both cases live here now: one project per size, standard and light-strip builds
    Each case project builds a standard case and a light-strip case from one
    code base (SILKSCREEN_VARIANT; build.py makes both) and fails if any part
    other than the tub differs. print/ holds the shared parts once plus
    tub-standard and tub-light-strip, replacing light-strip-print/.
    4.26in: the standard build is Rev K, part for part (empty boolean
    differences). 3.68in: the midplate notches and moved detent, the lid
    chamfer and the taller rocker caps become shared; the standard tub's
    detent pocket moves to match, and its caps stand 0.155 mm prouder than
    x3's (interim, until the bottom keys are redesigned).
    enclosures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
2026-09-27 Case-centric showcase for both sizes and both builds
    The showcase is now organised around the cases instead of the strip, like
    the Rev K page. It has size (4.26/3.68) and build (standard/light-strip)
    switches and a 3D stage where each part can be toggled, exploded, cut and
    pressed. The cards cover the bell-crank bottom keys in motion (both switch
    families), the light strip, side keys, the joint, USB-C, reset, the screen
    stack, detents, ribbons, the battery, 3.68 board prep, the Z stack, closing,
    edges, a comparison with the X4, assembly, checks (including "Measure
    before printing") and one print-file zip per size.
    showcase/ holds the source: per-size adapters that read each case project,
    a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
2026-09-28 OrcaSlicer plate projects for both case sizes
    print/silkscreen-426-plates.3mf and print/silkscreen-368-plates.3mf hold every
    printed part, laid out and set up for the Centauri Carbon 2 (stock 0.4 nozzle,
    0.20 mm Standard and Elegoo PLA profiles, no brim; keys, cranks and gates carry
    elephant-foot compensation 0 as a per-object setting). Plate 1 is the standard
    case, plate 2 the light-strip case, plate 3 the test prints (coupons, PCBA
    dummy) and the crank-M set for APEM-switch boards. All three plates of both
    files slice in OrcaSlicer 2.4. enclosures/make_plates.py regenerates them from
    each project's out/<variant>/print/ STLs.
2026-09-28 Clean up the repo: one print/ folder, case-426 / case-368, stale files removed
    - print/ now holds everything a builder prints: the two OrcaSlicer plate files
    (silkscreen-426-plates.3mf, silkscreen-368-plates.3mf), the rod jig, and each
    size's parts in print/4.26/ and print/3.68/ (STL + STEP, ROD.txt), with a
    README saying which file to open. The builds, make_plates.py, rod_jig.py and
    the showcase adapters write and read there. The 3.68's per-build coupon 3MFs
    are gone (plate 3 has them) and its parts lost the -print suffix.
    - The case projects are renamed enclosures/case-426 and enclosures/case-368;
    enclosures/README.md explains them, the shared scripts, the design records
    (BUT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
2026-09-28 ORDERING: match JLC's current flex form (stiffener and tape in one row, EDA software, confirm production file) and a remark within its 200 characters
2026-09-28 ORDERING: gold-finger thickness 0.295 (keeps JLC on PI 0.225), 3M9077 over tesa8854, liner pull tab
2026-09-29 Bottom keys: clearance for FDM (keys bound in the printed 4.26 tub); centre the 3.68 back logo
    Ian's printed 4.26 case took the rod, cranks and gate as designed, but the keys
    needed a lot of force to go in and then would not press freely. The analysis
    (both sizes, CAD and sliced G-code): the leaf holds the key's +Y face on the
    rail face, so all print error in Y landed on the chin side, where the foot and
    the cap had only 0.15 mm against rigid walls, and the cap's first layer
    (elephant-foot compensation 0) flared as it went through the opening. As printed
    that is about 0.1 mm of interference against stiff walls: 10-17 N of drag
    against a 2-3 N switch.
    The fix changes only the keys, the same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
2026-09-30 Test-2 fix: hook keys with slots in the chin wall (both cases)
    From Ian's second print of the 4.26 case: the bottom keys re-positioned,
    fell out of their openings and sat inconsistently, and the cranks drifted
    until the lid went on. The drag leaf held each key wherever it was left.
    - Keys: the drag leaf and its bump are gone. Each key has two rigid hooks
    (|dx| 3.95-4.95, 0.80 tall) that run in two slots in the tub's chin wall.
    Face down the key drops 1.00 onto them, level and 2.5 proud; the hooks
    cannot leave through the face because the key's +Y face rides the rail.
    Face up the key rests on its crank and the crank on the switch, with no
    free travel. The keys still print on their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
2026-09-30 Docs: x3 trim on boards before silkscreen-pcb Rev 1.01 needs two wires (3V3 to R81, GND C6 to C21); Rev 1.01 needs none
2026-10-08 4.26 variants, stage 5 (C9): READMEs for the 32 configurations; the showcase builds again
    READMEs:
    - case-426/README.md: "Builds" is now the four choices (panel, chin, side
    keys, dev header: what each changes and where), the slug grammar, LEFT
    and RIGHT as held (power at the top of the right edge, USB-C lower on
    the same edge), the four bases, a table of all 32 configurations (slug,
    side keys as held, length, whose lid it prints, what the board must not
    have, what it may leave off, its OrcaSlicer project's size and plate 1
    as sliced) and the board population per choice. New: how to build one
    configuration or all of them, with the times of the 2026-10-07 runs;
    the side-key lay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
2026-10-08 4.26 variants, stage 5 (C9): light-strip chinless as the showcase's fourth 4.26 build
    The showcase shows a fourth 4.26 build, "Light-strip chinless" ('lc'):
    its tub, the chinless lid, the plain panel and the light strip, no
    bottom keys. It fits the published page's limit: models-426.js is
    15,328,502 bytes with its tub's STL (its STEP stays in print/4.26/; with
    it the file would be about 16.3 MB).
    - Contract: EXTRA_BUILDS (cl, lc), STRIP_BUILDS (ls, lc), KEYLESS,
    BUILD_DIRS, zip folder light-strip-chinless/. BUILD_TOKENS: the page's
    data-only / data-not tokens a build answers to (cl also answers to std,
    lc to ls and cl), so the existing markup works for lc unchanged. The
    strip card w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
2026-10-11 3.68 standard tub: the 4.26's 35-degree screen bevel on a face raised 0.4 mm
    Ian: "go with +0.4 on the 3.68". The standard build's front face goes from Z 4.07 to
    4.47 (params.STD_FACE_RAISE, whole layers, asserted), so the skin over the panel's border
    is 1.0 and the window takes the 4.26's bevel: one 35-degree slope, 0.9 deep, 1.29 wide on
    the face, down to a 0.1 land; corners R0.4 at the screen, R1.69 on the face. The screen
    seen is unchanged (the active area + 0.5). The case is 11.7 mm (13.2 at the keys).
    Computed from the face: key-x3std is 0.4 taller, its hooks and the slots' roof 0.4
    higher; the two standard coupons follow the tub; the wordmark is 0.4 deep so it still
    prints two layers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
2026-10-11 Docs after the screen bevels: the numbers the reviews found stale
    - case-426 README: touch tubs 120.7-120.8 mm3 smaller; the bezels are measured
    0.4 mm behind the face (where compare.py cuts both cases); the tub's
    read-back is 99/99 with the window_bevel read (light-strip 98/98); the
    supports-off paragraph names the window_bevel check.
    - case-368 README: the RetroCase difference (2.8 mm thicker, 2.4 before the
    bevel); the screen bevel section as sliced (1.242 / 0.857 / 0.571 / 0.285 /
    0.000 from the lip line, 36 mm/s on the slope); the pre-bevel window size.
    - docs/DESIGN.md: key-x3ls is 0.8 mm taller than the standard key (1.2 before).
    - BELL-CRANK-SPEC.md: the x3 standard face 4.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
2026-10-12 3.68 lid closes: deeper midplate latch notches, 1.0 mm more air behind the board
    Ian's first 3.68 print (standard build, 2026-10-11) would not shut: the lid rocked and
    stopped about 1 mm short, with or without the battery. Two causes, both now checked on
    every build by src/lid_close.py (it fails on 9c5a639 and passes now):
    - The latch arms, bent 0.45 mm inward by the tub's tongue on the way in, landed on the
    midplate's 0.7 mm latch notch edge 0.68 mm before home (11 of 12 arms). Notch 1.6.
    - 0.1 mm of air over the pack left no room for a Rev 1.0 board's charging wires (the GND
    wire lies on C6 under the pack: 0.7 mm into a 5.2 pack with 1.0 mm wire). LID_DROP 1.0:
    the lid's back and fl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
2026-10-19 Docs: the 3.68 battery bay, its lead route and the 12.9 mm case
2026-10-21 The light strip on its own: the PCB project, fab outputs and docs; the cases moved to silkscreen-enclosures
2026-10-21 README: four review rounds, geometry.json origin, PowerShell commands, cold-voltage note, order row label
2026-10-21 README: AI-generated design notice, with a link to Silkscreen's AI disclosure
2026-10-22 Docs: name main-board parts in plain words, keep designators as labels
    Reader-facing text (README, NOTICE, assembly, ordering, safety guides) now names the frontlight connector, expansion header, power button and similar parts in plain words and gives the board designator only as a label. Technical docs introduce each designator with its plain name once. File names, code identifiers and generated files are unchanged.
2026-10-22 Docs: Back button is leftmost seen from the front; name the rework-wire parts and the two TP3s; say which J3 the schematic note means
